erikhafnor/surdeigsbaker/docs/beslutninger/README.md

# Beslutningslogg (ADR)

Viktige valg dokumenteres som korte *Architecture Decision Records* (ADR). En ADR forteller hva som ble valgt, hvorfor og hvilke alternativer som ble forkastet. Da kan nye bidragsytere og «framtidige deg» forstå valgene uten å gjette.

Mal: [`ADR-000-mal.md`](ADR-000-mal.md). Filnavn: `ADR-NNN-kort-tittel.md`.

| ID | Tittel | Status | Port |
|---|---|---|---|
| [ADR-000](ADR-000-mal.md) | Mal | – | – |
| [ADR-001](ADR-001-konseptvalg.md) | Konseptvalg for prototype v1 | Avgjort i ADR-010 | G3 |
| [ADR-002](ADR-002-plattform-maaleoppsett.md) | Plattform for måleoppsettet (fase 1) | Foreslått | G0 |
| [ADR-003](ADR-003-sprak-og-lisens.md) | Dokumentasjonsspråk og lisenser | Foreslått | G0 |
| ADR-004 | Hovedstyring for prototypen | Åpen | G2 |
| [ADR-005](ADR-005-verktoykjede.md) | Verktøykjede for design med AI-agenter | Foreslått | G0 |
| [ADR-006](ADR-006-steking-i-vanlig-ovn.md) | Maskinen leverer stekeklar deig, og stekingen skjer i vanlig ovn | **Vedtatt** | G0 |
| [ADR-007](ADR-007-ingen-kjoling.md) | Ingen kjøling i maskinen – kald etterheving skjer i brukerens kjøleskap | **Vedtatt** | G0 |
| [ADR-008](ADR-008-v0-design.md) | Første maskindesign (v0): benkemaskin med C-krok, varmeplate og 24 V | Erstattet av ADR-010 (v0 bygges ikke) | G2 |
| [ADR-009](ADR-009-kamera.md) | Kamera i maskinen – analysen gjøres utenfor maskinen («tynn kant») | Foreslått | G3 |
| [ADR-010](ADR-010-v1-arkitektur.md) | Prototype v1: brødmaskinform med vekt, dosering av mel, salt og vann, og tidsplanlegger | **Vedtatt** | G3 |
