erikhafnor/surdeigsbaker/docs/forskning/README.md

# Kunnskapsnotater (FO1–FO8)

Ett kort notat (1–3 sider) per forskningsområde i [forskningsplanen](../02-forskningsplan.md). Notatene skal være ferdige ved port G0.

| Fil | Område | Status |
|---|---|---|
| `FO1-prosess-og-mikrobiologi.md` | Prosess og mikrobiologi | ⚪ |
| `FO2-kjente-losninger.md` | Kjente løsninger og patenter | 🟡 forstudie gjort |
| `FO3-sensorer.md` | Sensorer | 🟡 forstudie gjort |
| `FO4-mekanikk.md` | Mekanikk og håndtering | ⚪ |
| `FO5-termikk.md` | Termikk | 🟡 grove tall i arkitekturdokumentet |
| `FO6-styring.md` | Styring og programvare | 🟡 plattformsammenligning gjort |
| `FO7-sikkerhet.md` | Sikkerhet og regelverk | 🟡 se 06-sikkerhet.md |
| `FO8-brukeropplevelse.md` | Brukeropplevelse | ⚪ |

Forstudien er oppsummert i [`02-forskningsplan.md`](../02-forskningsplan.md) under «foreløpige funn».

## Verktøyrapporter (verifisert 2026-10-13)

Hva som er det beste innen åpne verktøy for agentstyrt design. Rapportene er samlet i [`10-verktoykjede.md`](../10-verktoykjede.md).

- [3D/mekanisk CAD](verktoy/3d-cad.md)
- [Simulering, produksjon og visualisering](verktoy/simulering-og-produksjon.md)
- [Elektronikkdesign (EDA)](verktoy/elektronikk-eda.md)
- [Kretssimulering, fastvare og lab](verktoy/firmware-simulering-lab.md)

## Andre undersøkelser

- [Kamera og AI i maskinen](kamera-og-ai.md) (2026-10-16): maskinvare, hva andre har gjort, metoder og praktiske problemer. Grunnlag for [ADR-009](../beslutninger/ADR-009-kamera.md).
