erikhafnor/surdeigsbaker/docs/01-prosessanalyse.md

# 01 – Prosessanalyse: fra håndgrep til maskinfunksjoner

Her brytes referanseoppskriften ([`oppskrifter/referanse-v7.md`](../oppskrifter/referanse-v7.md)) ned i **maskinfunksjoner**. For hver funksjon vurderer vi hvor vanskelig den er å automatisere og hvilke løsninger som finnes. Til slutt foreslår vi en *maskinvennlig prosess*, som er en hypotese som eksperimentene skal teste.

**Avgrensning ([ADR-006](beslutninger/ADR-006-steking-i-vanlig-ovn.md) og [ADR-007](beslutninger/ADR-007-ingen-kjoling.md)):** Maskinen slutter når deigen er **klar for forming** (trinn 1–6). Forming, kald etterheving i eget kjøleskap og steking i vanlig ovn (trinn 7–15) gjøres av mennesket.

## Prosessflyt

Fargene viser hvor vanskelig hvert trinn er å automatisere: grønn er lett, gul middels og rød vanskelig. Grå trinn gjøres av mennesket.

```mermaid
flowchart LR
  subgraph M["Maskinen"]
    A["1 Mate surdeig / levain<br/>ca. 8 t, lunt"]:::hard --> B["2 Dosere mel og vann<br/>26 °C"]:::mid
    B --> C["3 Autolyse<br/>25–60 min"]:::easy
    C --> D["4 Salt og levain"]:::mid
    D --> E["5 Elting<br/>10 min"]:::easy
    E --> F["6 Bulkheving<br/>2–3 t, bretting"]:::mid
  end
  F -->|"varsel: klar for forming"| G
  subgraph U["Du, kjøleskapet og ovnen"]
    G["7–8 Forming<br/>(2–5 min)"]:::human --> H["9–10 Kald etterheving<br/>i kjøleskapet, 8–24 t"]:::human
    H --> I["11 Forvarm ovn og gryte"]:::human --> J["12 Tipp i gryta og snitt"]:::human
    J --> K["13–14 Steking<br/>250 → 200 °C"]:::human --> L["15 Avkjøling"]:::human
  end
  classDef easy fill:#d4edda,stroke:#2e7d32,color:#000
  classDef mid fill:#fff3cd,stroke:#b8860b,color:#000
  classDef hard fill:#f8d7da,stroke:#b71c1c,color:#000
  classDef human fill:#e2e3e5,stroke:#6c757d,color:#000
```

## Funksjonsanalyse

| # | Manuelt steg | Maskinfunksjon | Krav (utkast) | Vanskelighet | Kandidatløsninger | Kan forenkles? |
|---|---|---|---|---|---|---|
| 1 | Mate surdeig | Kassere, dosere mel og vann, røre, holde temperatur, oppdage når surdeigen er klar | ±2 g, 24–28 °C ±0,5 °C | **Høy** (klissent, hygiene, mugg) | Bygge levain direkte i bollen, peristaltisk pumpe for flytende surdeig, ToF-sensor for heving, modell for tid og temperatur | **Ja:** Med levain i bollen tilsetter mennesket bare 1 ss surdeig (N3) |
| 2 | Veie mel og vann | Dosere og veie, temperere vannet | Mel ±1 %, vann ±1 %, vann 26 ±1 °C | Middels | Lastceller under bollen (én vekt for alt), skrue- eller sneglemater for mel, peristaltisk pumpe eller magnetventil for vann | Nei, men på N2 gjør mennesket det |
| 3 | Autolyse | Vente og holde temperatur | 25–60 min | Lav | Temperaturstyrt kammer | Kanskje. Kan bli «fermentolyse» med levain fra start (E04). |
| 4 | Salt og levain | Dosere salt, blande inn levain | Salt ±0,5 g | Middels | **Salt som saltlake** (bassinage-prinsippet), laget av maskinen selv av tørt salt fra en snegle eller cellehjulsdoserer og vann (E12) | **Ja:** Saltlake gjør tørrstoffdosering om til væskedosering |
| 5 | Elting | Motor med krok eller padle | ca. 10 min, lav hastighet, ca. 1 kg deig | Lav | Brødmaskinpadle, spiralkrok, motor fra kjøkkenmaskin | – |
| 6 | Bulkheving med strekk og brett | Holde temperatur, bearbeide deigen med jevne mellomrom, måle heving | 24–27 °C, bretting hver 30. min, +20–25 % volum | Middels | Korte og langsomme krokomdreininger, ToF-sensor eller kamera for heving | **Ja:** Bretting kan kanskje erstattes av mer elting eller korte omrøringer (E05) |
| 7–8 | Forforming og endelig forming | Gi overflatespenning og stram form | – | **Svært høy** for maskin, **2–5 min** for menneske | Ingen forming der gryta er formen, eller at mennesket former når maskinen varsler | **Ja:** Variant «uten forming» (E06), eller manuell forming |
| 9–10 | Etterheving og kald heving | **Utenfor maskinen** ([ADR-007](beslutninger/ADR-007-ingen-kjoling.md)). Mennesket setter kurven (eller bollen) i sitt eget kjøleskap. | Kjøleskap 4–6 °C, 8–24 t | – | Brukerens kjøleskap | **Ja:** Ingen kjøling i maskinen |
| 11 | Forvarme ovn og gryte | **Utenfor maskinen.** Mennesket forvarmer når deigen tas ut av kjøleskapet. | Som referansen | Lav | – | – |
| 12 | Overlevering og snitting | **Mennesket** tipper kald deig fra bolle eller kurv i varm gryte og snitter | Uten å punktere deigen | Lav for menneske | Avtakbar bolle eller hevekurv med slippbelegg. Kald deig er lett å snitte. | Kanskje sømsiden opp (E07) |
| 13–15 | Steking og avkjøling | **Utenfor maskinen**, i vanlig ovn | Som referansen | – | – | – |
| – | Rengjøring | – | Mindre enn 5 min per brød | **Høy** | Avtakbare deler som tåler oppvaskmaskin, slippbelegg | Designes inn fra start |

## Hypotese: en maskinvennlig prosess (v0)

Eksperimentene i fase 1 skal bekrefte eller avkrefte denne hypotesen ([`05-eksperimenter.md`](05-eksperimenter.md)):

> **H0:** Et brød laget med prosessen under og stekt som referansen får ≥ 80 % av poengsummen til referansebrødet.

| Trinn | Referanse (v7.0) | Maskinvennlig v0 | Testes i |
|---|---|---|---|
| Levain | Separat glass, flytetest | I bollen. Mennesket tilsetter 1 ss surdeig. Ferdig etter modell (tid og temperatur), senere med sensor. | E02, E03 |
| Autolyse | Mel og vann først, deretter salt og levain | Fermentolyse: alt unntatt salt, deretter saltlake | E04 |
| Bretting | Hver 30. min for hånd | 3–4 korte og langsomme omrøringer med kroken | E05 |
| Forming | Forforming, benkhvile og endelig forming | **A:** Ingen («tipp og stek»). **B:** Mennesket former når maskinen varsler (standard i v0). | E06 |
| Etterheving | 2 t i kurv, så kjøleskap | **A:** Bollen med lokk i kjøleskapet. **B:** Kurven i kjøleskapet. | E09 |
| Venting etter bulk | – | Deigen venter ved romtemperatur til du former den. Maskinen slår av varmen. | E16 |
| Overlevering | Fra kurv til varm gryte | Mennesket tipper kald deig fra bolle (A) eller kurv (B) i varm gryte | E10 |
| Snitting | Kniv eller barberblad | Mennesket snitter, eller sømsiden opp | E07 |
| Steking | 260 °C forvarming, 250 °C med lokk, 200 °C uten | **Uendret**, i vanlig ovn | (E08) |

Hvis H0 holder med variant A, trenger maskinen verken forming eller avansert håndtering av deig. Variant B er en sikker reserveplan som gir referansekvalitet med to korte manuelle grep.

## Tidsplanlegging bakover («klar for forming kl. 20:00»)

Med styrt temperatur blir tiden for hvert trinn forutsigbar. Maskinen kan da regne baklengs fra tidspunktet du vil forme deigen:

```text
klar for forming 20:00  →  varsel, du former og setter kurven i kjøleskapet
     ↑
[venting ved romtemperatur: bare noen ti-minutter er trygt (E16)]
     ↑
bulkheving (modell: f(temperatur, levain-andel))  ←  temperaturen justeres for å treffe tiden
     ↑
elting / fermentolyse  ←  levain (modell: f(temperatur, forhold))  ←  start
```

Uten kjøling i maskinen ([ADR-007](beslutninger/ADR-007-ingen-kjoling.md)) finnes det ingen kald buffer *før* forming. Usikkerheten i surdeigens aktivitet (± 1–2 t) må derfor tas opp med **temperaturen** under bulkhevingen: Går den for fort, senkes temperaturen (men aldri under romtemperaturen). Går den for sakte, økes den. Etter formingen er det **kjøleskapet ditt** som er bufferen (8–24 t), så du slipper å steke på minuttet.

Tidsplanleggeren kommer når fermenteringsmodellen fra E02 finnes. Fastvaren i v0 starter når du trykker **Start**, og slutter når hevingen har nådd målet.
