erikhafnor/surdeigsbaker/data/bakelogger/README.md

# Bakelogger

Legg én fil per baking her, basert på [`docs/maler/bakelogg.md`](../../docs/maler/bakelogg.md). Den første skal være **E01 – referansebrød nr. 1**.
