erikhafnor/surdeigsbaker/docs/03-konsepter.md

# 03 – Konseptalternativer

> **Oppdatert 2026-10-17:** Maskinen har **ingen kjøling** ([ADR-007](beslutninger/ADR-007-ingen-kjoling.md)). Den slutter når deigen er klar for forming, og du bruker ditt eget kjøleskap til den kalde etterhevingen. **Prototype v1 er valgt i [ADR-010](beslutninger/ADR-010-v1-arkitektur.md):** en blanding av K2 og K1. Fra K2 kommer det isolerte kammeret med svak varme, dosering og vekt. Fra K1 kommer brødmaskinformen med elteblad i bunnen, men drevet av en egen girmotor. Det første designet, v0 (K2 med krok fra lokket), bygges ikke. Teksten under er skrevet før dette. Det som gjelder kjøling, er ikke lenger aktuelt.

Maskinen leverer deig som er **klar for forming**, og stekingen skjer i vanlig ovn ([ADR-006](beslutninger/ADR-006-steking-i-vanlig-ovn.md)). Da er de viktigste valgene i arkitekturen:

- **Hvordan elter og bearbeider maskinen deigen?** Brødmaskinpadle, krok eller kjøkkenmaskin.
- **Hvordan varmes deigen?** Varmeplate under bollen eller varm luft i kammeret. (Ingen kjøling etter ADR-007.)
- **Hvordan får mennesket deigen ut?** Avtakbar bolle eller hevekurv.

Under er fire konsepter. Valget skulle tas ved port G3 med Pugh-matrisen nederst. Det ble i stedet tatt i [ADR-010](beslutninger/ADR-010-v1-arkitektur.md) ut fra undersøkelsene for v1 (se [ADR-001](beslutninger/ADR-001-konseptvalg.md)).

## K1 – Brødmaskin i kjøleskap

Drivverket og formen fra en brukt brødmaskin bygges inn i et **ombygd lite vinkjøleskap eller en kjøleboks med kompressor**. Den får ny styring, et svakt varmeelement og egne sensorer.

```text
┌───────────────────────────────┐
│ isolert kammer (vinkjøleskap) │ ← kompressor 4–6 °C, varmefolie til 24–30 °C
│   ┌──────────────┐            │
│   │ brødform     │  ToF ↓     │ ← avtakbar form med slippbelegg
│   │   padle      │            │
│   └──────┬───────┘            │
│      eltemotor (fra brødmaskin) │
│ ESP32 · SSR/relé · termosikring │
└───────────────────────────────┘
```

- **+**
  - Billig: brødmaskin og vinkjøleskap kan kjøpes brukt på Finn.no.
  - Kort vei til *første maskinlagde surdeigsdeig*.
  - Brødformen er laget for elting og er lett å vaske.
  - Høy DIY-verdi: mange kan bygge den.
- **−**
  - Brødmaskinpadlen behandler deigen grovere enn en krok.
  - Formen er høy og smal, noe som er dårlig for å se og måle bulkhevingen.
  - Motorvarmen havner i kjølekammeret.
  - Lite plass til en hevekurv, og vanskelig å dosere ovenfra (N3).
- **Rolle i planen:** Gangbart skjelett i fase 2. Kan bli en egen, enkel DIY-variant («Surdeigsbaker Mini»).

## K2 – Eltebolle i hevekammer ⭐ grunnlaget for v1 (uten kjøling, med brødmaskinform fra K1)

Et isolert kammer med svak varme (kompressorkjøling i den opprinnelige versjonen, fjernet i ADR-007). I kammeret står en **avtakbar bolle i rustfritt stål** på lastceller, og en **eltekrok som drives ovenfra** av en girmotor i lokket. Lokket har også ToF-sensor og innløp for dosering. Kammeret har plass til en hevekurv ved siden av eller i stedet for bollen.

```text
┌───────────────────────────────────┐
│  Melbeholder      Vann · salt     │ ← påfylles ukentlig (N3)
├────────── lokk ───────────────────┤
│  girmotor → krok   ToF   innløp   │
├───────────────────────────────────┤
│   avtakbar bolle (rustfritt)      │ ← 4–30 °C
│   på lastceller   │ plass til     │
│                   │ hevekurv      │
│ kompressor · varme · ESP32/MCU    │
└───────────────────────────────────┘
```

- **+**
  - Kroken gir god deigbehandling og fungerer godt til korte bretterunder (E05).
  - Bulkhevingen er lett å måle ovenfra.
  - Dosering ovenfra gjør N3 mulig.
  - Bollen og kroken tåler oppvaskmaskin.
  - Støtter begge overleveringsvariantene («tipp og stek» og «med forming»).
- **−**
  - Mer mekanisk arbeid: lokk med motor og en kobling som må kunne løftes av.
  - Motorvarme og kondens i kammeret må håndteres.
- **Kritiske eksperimenter:** E05 (bretting med krok), E06 (uten forming), E10 (overlevering), E13 (varme) og **E17 (eltetest)**.

## K3 – Kjøkkenmaskin og smart hevekabinett

Den kjøkkenmaskinen du har, brukes til elting. Det som bygges, er bare et **smart hevekabinett** med varme, hevemåling, tidsplan og varsling. Mennesket flytter bollen mellom kjøkkenmaskinen og kabinettet og gjør bretting og forming.

- **+**
  - Lavest teknisk risiko.
  - Raskest i bruk: dette er hevekassen fra fase 1.
  - Gir referansekvalitet, fordi mennesket gjør alle håndgrepene.
  - Nyttig i hverdagen allerede på N1.
- **−**
  - Lav automasjon: mennesket må gjøre flere grep og være til stede oftere.
  - To apparater på benken.
- **Rolle i planen:** Første nyttige milepæl (N1), og plattformen for alle eksperimentene i fase 1.

## K4 – Heving i stekegryta (kaldstart)

Den siste hevingen skjer i din egen jerngryte, med bakepapir, inne i maskinens kammer. Ved stekeklar tid setter du hele gryta i en **kald** ovn og steker med kaldstart.

- **+** Ingen tipping av deig. Bakepapiret fungerer som slynge.
- **−**
  - Kaldstart kan gi mindre ovnsspretthet (E08).
  - Kammeret må romme en tung støpejernsgryte, og det er mye masse å kjøle ned.
  - Kald emaljert gryte inn i varm ovn må unngås, fordi emaljen kan sprekke av temperatursjokk.
- **Rolle:** Utgår etter ADR-007, fordi maskinen ikke lenger har kaldt kammer. Kaldstart i gryte kan fortsatt testes i E08 med brukerens kjøleskap.

## Foreløpig Pugh-matrise

Konsept K2 er referanse (0). De andre konseptene vurderes mot K2 fra −2 (mye dårligere) til +2 (mye bedre). Vektene skal kalibreres i fase 0. Poengene oppdateres etter eksperimentene i fase 1 og 3.

| Kriterium | Vekt | K1 | K2 | K3 | K4 |
|---|---|---|---|---|---|
| Deigkvalitet | 5 | −1 | 0 | +1 | −1 |
| Teknisk risiko (lav er bra) | 4 | +1 | 0 | +2 | 0 |
| Automasjonsnivå mulig i v1 | 4 | −1 | 0 | −2 | 0 |
| Kostnad | 3 | +2 | 0 | +1 | 0 |
| Fotavtrykk på benken | 3 | 0 | 0 | −1 | −1 |
| Rengjøring | 3 | 0 | 0 | 0 | 0 |
| Byggbarhet som DIY | 3 | +1 | 0 | +2 | 0 |
| Tid til første brød | 2 | +2 | 0 | +2 | 0 |
| **Vektet sum** | | **+8** | **0** | **+15** | **−8** |

Matrisen må leses riktig. K3 skårer høyest fordi den er enkel, men den når bare N1. K1 er billig og rask, men egner seg dårlig for dosering (N3). **K2 er den reelle kandidaten for prototype v1 (N3).** K1 og K3 er trinn på veien dit, og de er nyttige ferdige maskiner i seg selv.

## Anbefaling: en trapp der hvert trinn er nyttig

Den opprinnelige trappen var:

1. **Fase 1, K3 (N1):** Hevekabinett med varme, sensorer og tidsplan som eksperimentkammer.
2. **Fase 2, K1 (N2):** Drivverket og formen fra en brødmaskin i kabinettet.
3. **Fase 3–4, K2 (N3):** Den egentlige eltemodulen med bolle, krok, vekt og dosering.

**Etter ADR-007, ADR-008 og ADR-010** bygges K2 uten kjøling direkte som **prototype v1 (N3)**, med formen og eltebladet fra K1. Trinn 1 og 2 blir valgfrie, og v0 bygges ikke. Eksperimentene i fase 1 kan gjøres for hånd eller i v1.
