erikhafnor/surdeigsbaker/docs/08-kilder.md

# 08 – Kilder og leseliste

Kildelisten ble satt sammen i forstudien i oktober 2026. **De fleste nettsidene er funnet via søkeresultater og er ikke lest i sin helhet.** Kilder på GitHub er lest direkte. Viktige tall bør sjekkes i originalkilden før vi bygger på dem. Legg gjerne til nye kilder med en kort merknad om hva den er nyttig til.

⭐ = start her

## Bøker

- ⭐ Chad Robertson: *Tartine Bread*. Grunnlaget for referanseoppskriften.
- ⭐ Trevor J. Wilson: *Open Crumb Mastery* (2. utg.). Om fermentering og struktur, uten oppskrifter. <https://trevorjaywilson.sellfy.store/p/open-crumb-mastery/>
- Jeffrey Hamelman: *Bread*, 3. utg. (Wiley 2021), ISBN 9781119577515
- Maurizio Leo: *The Perfect Loaf* (Clarkson Potter 2022), ISBN 9780593138410
- Ken Forkish: *Flour Water Salt Yeast*, ISBN 9781607742739. Inneholder bl.a. teknikken med sømsiden opp.
- Nathan Myhrvold og Francisco Migoya: *Modernist Bread* (2017)
- Gobbetti og Gänzle (red.): *Handbook on Sourdough Biotechnology*, 2. utg. (2023)
- ⭐ *The Sourdough Framework*, en åpen bok om surdeig: <https://github.com/hendricius/the-sourdough-framework>

## Fagartikler og vitenskap

- Gänzle, Ehmann og Hammes (1998): modell for hvordan pH, temperatur og salt påvirker surdeigsorganismene. *Appl. Environ. Microbiol.* 64:2616. <https://pmc.ncbi.nlm.nih.gov/articles/PMC106434>
- Gänzle (2014): «Enzymatic and bacterial conversions during sourdough fermentation». *Food Microbiology* 37:2–10. <https://era.library.ualberta.ca/items/20231cb2-c13f-43c4-9d59-1d686b67f5b8>
- De Vuyst mfl. (2014): «Microbial ecology of sourdough fermentations: diverse or uniform?» <https://research.dial.uclouvain.be/handle/2078.5/39545>
- ⭐ Landis mfl. (2021): Global Sourdough Project, 500 surdeiger. *eLife* 10:e61644. <https://elifesciences.org/articles/61644> (data: <https://datadryad.org/dataset/doi:10.5061/dryad.0p2ngf1z1>)
- Reese mfl. (2020): Om ingredienser og bakernes betydning. *mSphere*. <https://www.ncbi.nlm.nih.gov/pmc/articles/PMC6968659/>
- Romano mfl. (2007): Deigvolum målt med bildeanalyse og Gompertz-modell. *J. Food Eng.* 83(2). <https://iris.unina.it/handle/11588/112136>. Se også *Foods* 12:1809 (2023): <https://www.mdpi.com/2304-8158/12/9/1809>
- Ito mfl. (1992): Dielektrisk måling av gassandel i deig. *Cereal Chem.* 69:325. <https://www.cerealsgrains.org/publications/cc/backissues/1992/Documents/69_325.pdf>
- De Bondt mfl.: «Wheat sourdough breadmaking: a scoping review». <https://research.ucc.ie/en/publications/wheat-sourdough-breadmaking-a-scoping-review/>
- pH og titrerbar syre (TTA): Metrohm. <https://www.metrohm.com/en/discover/blog/20-21/chemical-analysis-of-sourdough--ph-and-total-titratable-acidity-.html>
- Referanseinstrument: KPM Rheo F4 (tidligere Chopin Rheofermentometer). <https://kpmanalytics.com/products/rheo-f4>

## Praktisk bakekunnskap (blogger og forum)

- King Arthur om myter, bl.a. flytetesten: <https://cmsprod.kingarthurbaking.com/blog/2024/04/24/sourdough-myths>
- King Arthur om kald gryte: <https://www.kingarthurbaking.com/blog/2017/07/05/baking-in-a-cold-dutch-oven>
- King Arthur om hvordan man ser at brødet er ferdig: <https://www.kingarthurbaking.com/blog/2023/05/31/how-to-tell-if-bread-is-done>
- Prosent heving i bulk, avhengig av temperatur: <https://thesourdoughjourney.com/the-mystery-of-percentage-rise-in-bulk-fermentation/>
- Ønsket deigtemperatur (DDT): <https://www.bakerybits.co.uk/bakers-blog/desired-dough-temperature-a-baker-s-guide>
- Tid og temperatur, «dobling per ca. 8 °C»: <https://thermoworks.com/blogs/thermoblog/sourdough-times-and-temps>
- Blandingsforhold og tid til topp (anekdotisk): <https://thatsourdoughgal.com/the-ultimate-guide-to-sourdough-starter-feeding-ratios/>
- America's Test Kitchen, no-knead 2.0 (hydrering): <https://www.americastestkitchen.com/articles/41-no-knead-bread-2-dot-0>
- The Fresh Loaf (forum), en gullgruve av erfaringer: <https://www.thefreshloaf.com/>

## Kjente løsninger (produkter)

- ⭐ Sourdough Sidekick (FirstBuild/GE og King Arthur), en automatisk surdeigsmater: <https://www.kingarthurbaking.com/blog/2026/06/23/automatic-sourdough-feeder>
- Brød & Taylor Sourdough Home og Folding Proofer: <https://nz.brodandtaylor.com/pages/faq>, <https://brodandtaylor.com/support>
- Breadwinner, en sensor for surdeigsglass (åpen design fra OSHWA 2021): <https://www.backerkit.com/c/projects/fred-benenson/breadwinner>, <https://2021.oshwa.org/files/2021/04/Breadwinner.pdf>
- Panasonic SD-YR2550, med surdeigsprogrammer og romtemperatursensor: <https://www.panasonic.com/uk/consumer/home-appliances/breadmakers/sd-yr2550.html>
- Zojirushi Virtuoso Plus, med egne «Homemade»-program: <https://www.zojirushi.com/app/product/bbpdc>
- Breville Custom Loaf, med padle som felles ned: <https://www.breville.com/en-us/product/BBM800>
- Målte temperaturer i brødmaskiner (forum): <https://www.thefreshloaf.com/node/72212>
- ⭐ Anova Precision Oven og utvikler-API (trinnliste med betingelser): <https://developer.anovaculinary.com/docs/devices/wifi/oven-commands>
- Suvie, med «Cool-to-Cook»: <https://sousvideguy.com/meet-suvie-one-sous-vide-oven/>
- Whirlpool Polara, et kjøleskap og en ovn i ett (2002): <https://newatlas.com/oven-that-thinks-its-a-refrigerator/1524/>
- Rotimatic, lærdom om dosering: <https://support.rotimatic.com/articles/2057615-imperfect-dough>
- Wilkinson BreadBot: <https://thespoon.tech/four-years-after-ces-breadbots-robotic-breadmaker-is-dishing-out-loaves-at-grocery-stores/>
- Thermomix TM6, gjæringsmodus: <https://cookidoo.be/foundation/en/articles/tm6-modes>

## DIY og åpen kildekode

- ⭐ Justin Lam, surdeigsmonitorer (kamera og ToF med MQTT): <https://github.com/justinmklam/sourdough-starter-monitor>, <https://github.com/justinmklam/iot-sourdough-starter-monitor>
- Surdeigsglass med ToF og CO₂ (SCD30): <https://github.com/AKAMEDIASYSTEM/aka-multispec-jar>
- DIY hevekasse med Raspberry Pi og kamera: <https://github.com/hendricius/diy-proofing-box>
- ⭐ BrewPiLess og Fermentrack, styring av gjæringskammer med varme og kjøling: <https://github.com/vitotai/BrewPiLess>, <https://github.com/thorrak/fermentrack>
- Brødmaskin styrt med Arduino (University of Western Macedonia, 2015): <https://arch.ece.uowm.gr/projects/breadmaker2015/>
- Fastvare for brødmaskin (GPL-3): <https://github.com/bread-maker/bread-maker-firmware>
- Hevekasse med Peltier (The Fresh Loaf): <https://www.thefreshloaf.com/node/31641>
- OnionBot, kjøkkenassistent med maskinsyn: <https://github.com/onionbot/OnionBot-SousChef>

## Industri

- Konisk «rounder»: <https://www.bakeit.it/en/products/conical-bread-dough-rounder>
- Retarder-proofer (kjøl og heving i samme kammer): <https://empirebake.com/lrpr-1-single-door-proofer-retarder>, patent US4674402: <https://patents.google.com/patent/US4674402>
- Deling og runding: <https://innograin.uva.es/en/2023/11/10/division-and-rounding/>
- Snitteroboter (ultralyd og vannstråle): <https://www.koenig-rex.com/en/machines/scoring-unit/>

## Maskinvare og programvare

> Verktøy for CAD, EDA, simulering og fastvare med agentstøtte (MCP) er samlet i [`10-verktoykjede.md`](10-verktoykjede.md) og de fire rapportene i [`forskning/verktoy/`](forskning/verktoy/).

- ⭐ ESPHome (PID-regulering, HX711, NAU7802, MAX318xx): <https://esphome.io/>
- ⭐ Klipper, konfigurasjonsreferanse (varmesikkerhet, `load_cell`, `manual_stepper`): <https://github.com/Klipper3d/klipper/blob/master/docs/Config_Reference.md>
- MadMachine SwiftIO Micro: <https://docs.madmachine.io/hardware/swiftio-micro>, SDK: <https://github.com/madmachineio/mm-sdk>, drivere: <https://github.com/madmachineio/MadDrivers>
- Embedded Swift (ESP32-C6, RP2040 og flere): <https://swift.org/blog/embedded-swift-examples/>
- Datablad for HX711: <https://github.com/sparkfun/HX711-Load-Cell-Amplifier/blob/master/datasheets/hx711F_EN.pdf>
- Datablad for NAU7802: <https://cdn.sparkfun.com/assets/e/c/8/7/6/NAU7802_Data_Sheet_V1.7.pdf>
- Datablad for MAX31865: <https://www.makerguides.com/wp-content/uploads/2024/06/max31865-datasheet.pdf>
- Datablad for STC31 (CO₂ 0–100 vol%): <https://cdn.sparkfun.com/assets/4/2/5/0/6/STC31_datasheet.pdf>
- ST AN5231, dekkvindu for VL53L1X: <https://cdn.sparkfun.com/assets/learn_tutorials/7/8/4/an5231-cover-window-guidelines-for-the-vl53l1x-longdistance-ranging-timeofflight-sensor-stmicroelectronics.pdf>
- Secop BD35F, 12/24 V kompressor: <https://www.secop.com/fileadmin/user_upload/SEPS/datasheets/en/bd35f2_101z0700_r134a_12-24vdc_02-2026_desd102n202.pdf>
- Peltier-kammer, målt COP: <https://iifiir.org/en/fridoc/optimization-of-operational-conditions-for-a-thermoelectric-141528>
- Brodannelse og «ratholing» i pulverdosering: <https://www.processingmagazine.com/material-handling-dry-wet/weighers-feeders/article/53079307/understanding-ratholing-and-bridging-phenomena-in-bulk-powder-feeding>

## Sikkerhet og regelverk

- ⭐ DSB, elsikkerhet og elektriske produkter: <https://www.dsb.no/elsikkerhet/elektriske-produkter/elektriske-produkter/>
- DSB, hva du kan gjøre selv: <https://www.dsb.no/en/Safe-everyday-life/Eletricity/Electrical-work_91-You-can-do-this-yourself/>
- DSB, produsentens plikter: <https://www.dsb.no/produkter-og-forbrukertjenester/veiledning/produsentens-forpliktelser/>
- DSB, evaluering av komfyrvaktkampanjen (statistikk over komfyrbranner): <https://www.dsb.no/contentassets/8af8e1908ed04de18d925b8c6836f46d/evalueringsrapport_komfyrvaktkampanjen_2017.pdf>
- Regjeringen, elektrisk utstyr (FEU) og EMC: <https://www.regjeringen.no/en/topics/business-and-industry/product-contact-point/general-rules/electrical-equipment/id2830912/>
- Mattilsynet, matkontaktmaterialer: <https://mattilsynet.no/mat-og-drikke/matproduksjon/matkontaktmaterialer/produksjon-import-og-salg-av-matkontaktmaterialer>
- EU-forordning 1935/2004 (rammeforordningen for matkontakt): <https://www.ruokavirasto.fi/en/foodstuffs/food-sector/packages-and-other-food-contact-materials/rules-for-food-contact-materials/framework-regulation-eu-19352004/>
- Maskinforordningen (EU) 2023/1230: <https://eur-lex.europa.eu/eli/reg/2023/1230>
- Radioutstyrsdirektivet (RED, 2014/53/EU): <https://eur-lex.europa.eu/eli/dir/2014/53/2022-12-27/eng/pdf>
- IEC 60335-2-9 (omfatter brødmaskiner): <https://www.sis.se/en/produkter/environment-health-protection-safety/domestic-safety/iec-60335-2-92019/>
- PTFE og polymerrøyk (Chemours): <https://www.teflon.com/en/polymer-fumes>
- BfR om aluminium og sur mat: <https://www.bfr.bund.de/en/press-release/bfr-research-proof-of-the-transfer-of-aluminium-from-menu-trays-to-food/>
- Trådtrekk (rope) i brød, *Bacillus*: <https://pmc.ncbi.nlm.nih.gov/articles/PMC9564316>
- Mattrygghet ved 3D-print: <https://wiki.comakingspace.de/3D_printing_food_safety>

## Mulige fagmiljøer og nettverk

- **Nofima**, norsk matforskningsinstitutt med korn- og bakeforskning. Kan være aktuelt for en faglig samtale eller instrumenttilgang.
- **Lokale håndverksbakerier**, for kunnskap om praksis og deigforståelse
- **Universitetets verksteder og makerspace** (f.eks. ved UiS), for verktøy og fagfolk
- **Nettsamfunn:** The Fresh Loaf, r/Sourdough, r/Breadit og norske surdeigsgrupper på Facebook. Hackaday.io egner seg som byggelogg.
