erikhafnor/surdeigsbaker/docs/beslutninger/ADR-001-konseptvalg.md

# ADR-001: Konseptvalg for prototype v1

- **Status:** avgjort i [ADR-010](ADR-010-v1-arkitektur.md) (brødmaskinform med elteblad i bunnen, vekt og dosering).
- **Dato:** –
- **Port:** G3

## Kontekst

Se [`03-konsepter.md`](../03-konsepter.md). Maskinen leverer deig som er klar for forming. Stekingen skjer i vanlig ovn ([ADR-006](ADR-006-steking-i-vanlig-ovn.md)), og den kalde etterhevingen i brukerens kjøleskap ([ADR-007](ADR-007-ingen-kjoling.md)).

**Oppdatert 2026-10-16:** v0 er designet som K2 uten kjøling ([ADR-008](ADR-008-v0-design.md)). Denne ADR-en gjelder nå valget for **v1**, og tas med data fra v0. **K3 (smart hevekabinett)** og **K1 (brødmaskin)** er ikke lenger nødvendige trinn på veien.

## Data som trengs før beslutningen

| Eksperiment | Spørsmål | Resultat |
|---|---|---|
| E05 | Kan bretting gjøres av maskinen? | – |
| E06 | Trengs forming? | – |
| E07 | Trengs snitting? | – |
| E09 | Kald bulkheving eller kald etterheving? | – |
| E10 | Er overleveringen enkel for mennesket (bolle eller kurv)? | – |
| E13 | Holder varmeplaten deigen på 24–27 °C ±0,5 °C? | – |
| E16 | Hvor lenge kan deigen vente ved romtemperatur etter bulk? | – |
| E17 | Elter C-kroken i v0 godt nok? | – |

## Beslutning

–

## Konsekvenser

–
