erikhafnor/surdeigsbaker/docs/maler/bakelogg.md

# Bakelogg – mal

> Kopier filen til `data/bakelogger/ÅÅÅÅ-MM-DD-kortnavn.md`, eller opprett et issue med malen «Bakelogg». Fyll inn det du kan. Tomme felt er bedre enn gjetning.

## Grunndata

| Felt | Verdi |
|---|---|
| Dato | |
| Bakt av | menneske / maskin (versjon: …) |
| Oppskrift og versjon | f.eks. `referanse-v7` eller `maskinvennlig-v0` |
| Eksperiment-ID | f.eks. E05-b (eller «–») |
| Automasjonsnivå | N0–N5 |
| Overlevering | A «tipp og stek» / B «med forming» |
| Klar for forming: planlagt / faktisk | kl. … / kl. … (avvik: … min) |
| Ventetid før forming / tid i kjøleskap | … min / … t |

## Ingredienser (veid)

| Ingrediens | Merke / parti | Gram | Temperatur (°C) |
|---|---|---|---|
| Siktet hvetemel | | | |
| Sammalt mel | | | |
| Vann | | | |
| Salt | | | – |
| Levain | | | |

Romtemperatur: … °C. Relativ luftfuktighet: … %.

## Levain

| Matet kl. | Forhold (kultur:mel:vann) | Temperatur | Topp kl. | Hevefaktor ved topp | Flytetest (kl. / resultat) | pH (valgfritt) |
|---|---|---|---|---|---|---|
| | | | | | | |

## Prosess

| Trinn | Start | Slutt | Deigtemperatur (°C) | Merknad (bretting, konsistens …) |
|---|---|---|---|---|
| Blanding | | | | |
| Autolyse | | | | |
| Elting | | | | |
| Bulkheving | | | | Heving i måleglass: … % |
| Forforming og benkhvile | | | | |
| Endelig forming | | | | |
| Etterheving på benk | | | | |
| Kald heving | | | | Kjøleskap: … °C |
| Forvarming | | | | Gryte: … |
| Steking med lokk | | | | … °C |
| Steking uten lokk | | | | … °C |

## Resultat

| Måling | Verdi |
|---|---|
| Deigvekt før steking (g) | |
| Brødvekt etter avkjøling (g) | |
| Stekesvinn (%) | |
| Kjernetemperatur ved uttak (°C) | |
| Volum (ml), med metode | |
| Spesifikt volum (ml/g) | |
| Høyde / bredde (cm) | |

## Brødkort (1–5)

Se [brødkortet](../00-visjon-og-suksesskriterier.md#brødkortet-kvalitetsmåling).

| Volum (25 %) | Form (15 %) | Krumme (20 %) | Skorpe (15 %) | Smak (20 %) | Gjennomstekt (5 %) | **Vektet sum** |
|---|---|---|---|---|---|---|
| | | | | | | |

## Bilder

- [ ] Hele brødet ovenfra og fra siden, med linjal i bildet
- [ ] Snitt gjennom midten, med linjal i bildet
- [ ] Skorpe i nærbilde

## Notater og lærdom

-
