erikhafnor/surdeigsbaker/docs/beslutninger/ADR-000-mal.md

# ADR-NNN: Tittel

- **Status:** foreslått / vedtatt / erstattet av ADR-XXX / forkastet
- **Dato:**
- **Port:** G0–G5

## Kontekst

Hvilket problem skal løses? Hvilke krav, begrensninger og data (eksperimenter) er relevante?

## Alternativer

1. **Alternativ A:** fordeler og ulemper
2. **Alternativ B:** fordeler og ulemper

## Beslutning

Vi velger … fordi …

## Konsekvenser

Hva blir enklere, hva blir vanskeligere, og hva må følges opp?
