erikhafnor/surdeigsbaker/docs/maler/eksperiment.md

# Eksperiment EXX – navn

| Felt | Verdi |
|---|---|
| ID | EXX (se [eksperimentplanen](../05-eksperimenter.md)) |
| Status | planlagt / pågår / ferdig / avbrutt |
| Ansvarlig | |
| Dato (start–slutt) | |
| Forskningsområde | FO1–FO8 |
| Prioritet | 🔴 / 🟠 / 🟢 |

## Spørsmål

Hva skal vi finne ut? Hvilken designbeslutning avhenger av svaret?

## Hypotese

«Vi tror at …, og regner hypotesen som bekreftet hvis …»

## Metode

- **Varianter:** (a) referanse, (b) …, (c) …
- **Faste faktorer:** oppskrift, melparti, temperaturer …
- **Antall repetisjoner:** ≥ 2
- **Utstyr:**

## Målinger

| Måling | Metode / sensor | Enhet | Oppløsning |
|---|---|---|---|
| | | | |

## Kriterium for bestått

## Resultater

Lenke til rådata i `data/` og bakelogger. Grafer.

## Konklusjon og konsekvens for designet

- Hva lærte vi?
- Hvilke beslutninger (ADR) eller dokumenter må oppdateres?
- Nye spørsmål?
