erikhafnor/surdeigsbaker/hardware/v1/bilder/v1_lukket.png

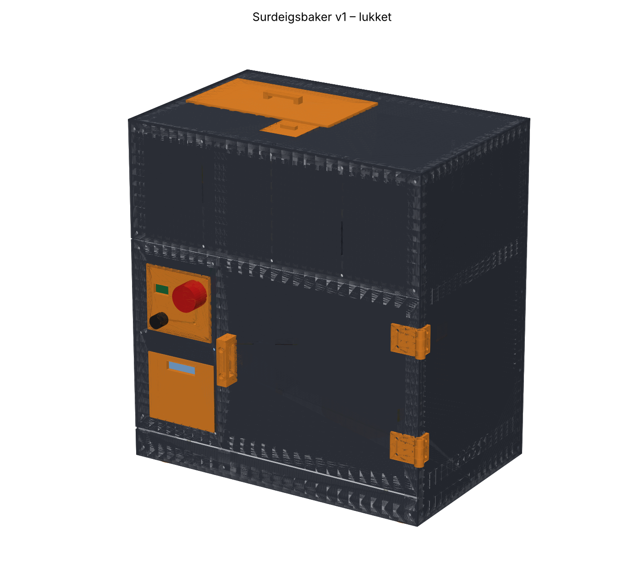
hardware/v1/bilder/v1_lukket.png
