erikhafnor/surdeigsbaker/hardware/v1/bilder/v1_snitt_front.png

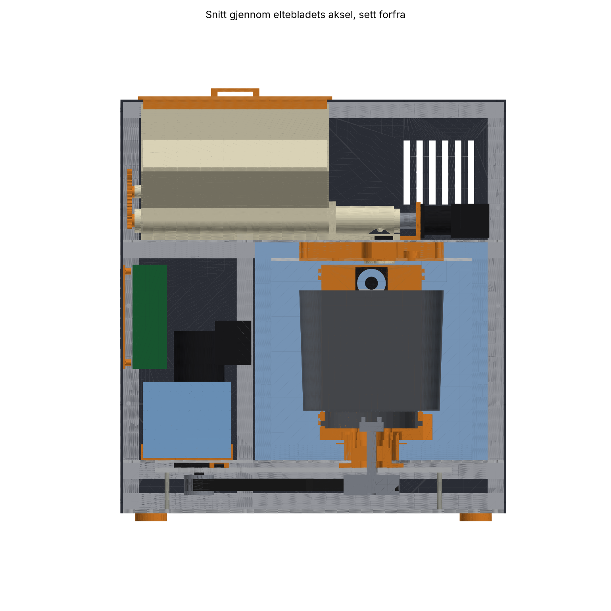
hardware/v1/bilder/v1_snitt_front.png
