erikhafnor/surdeigsbaker/hardware/v1/tegninger/plater_oversikt.png

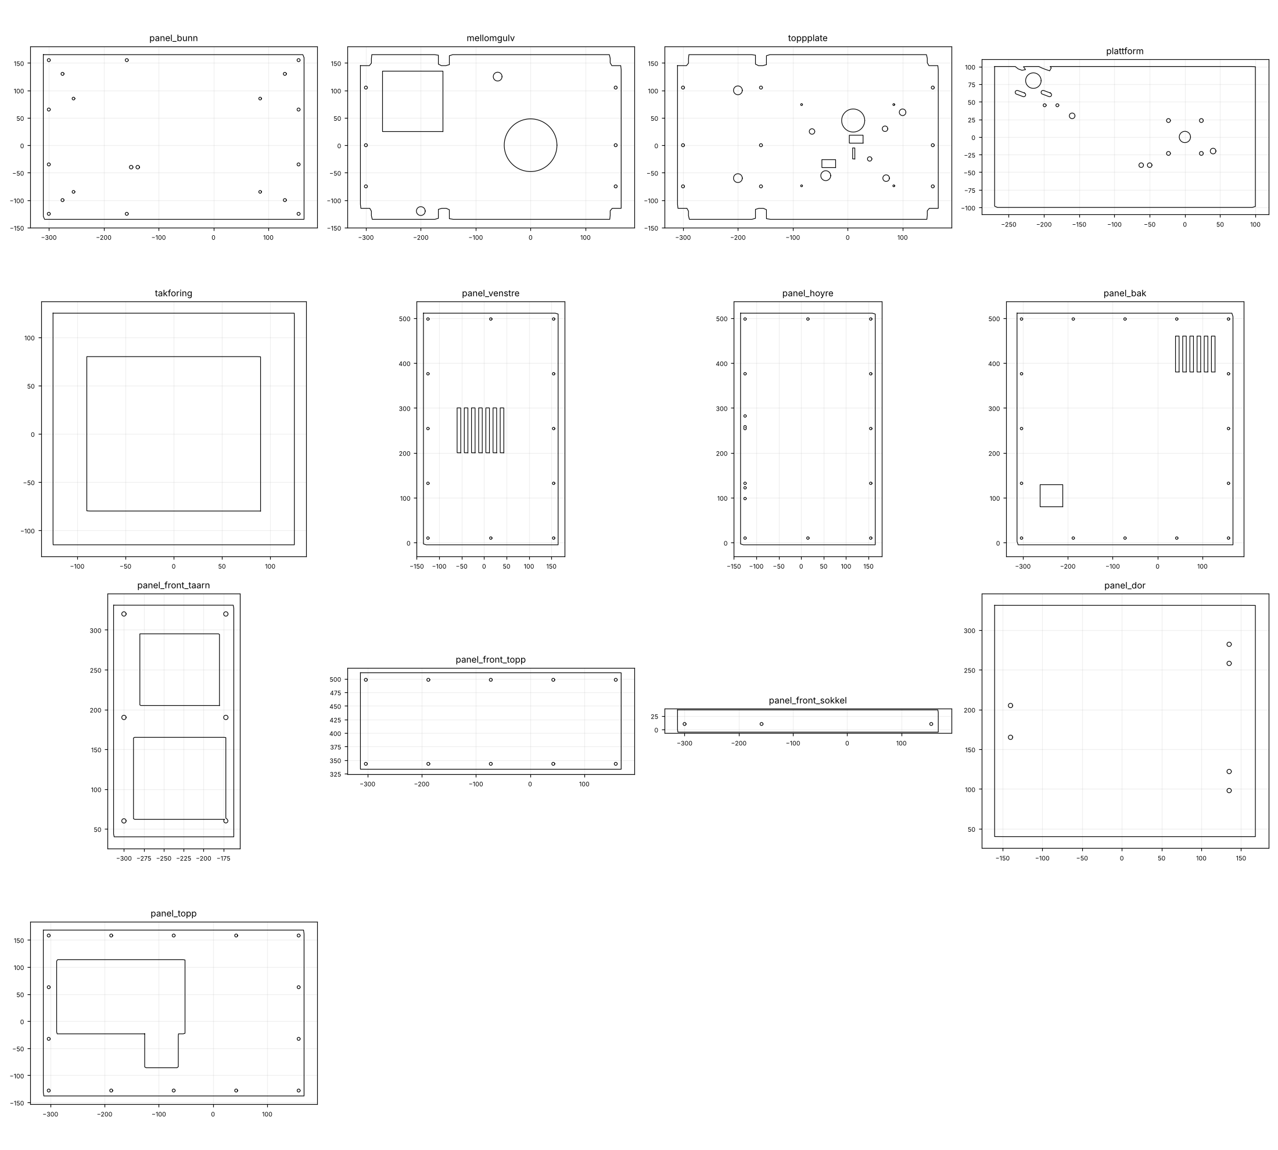
hardware/v1/tegninger/plater_oversikt.png
