erikhafnor/surdeigsbaker/hardware/v1/dxf/panel_dor.dxf

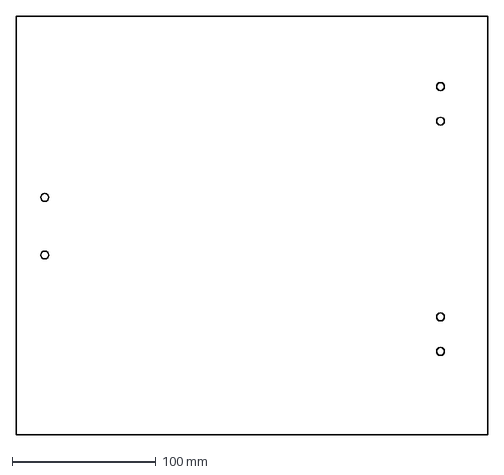
[picture p9: CAD file, 2026-10-16]
hardware/v1/dxf/panel_dor.dxf
328.0 x 291.0 mm
