erikhafnor/surdeigsbaker/hardware/v1/step/dorhandtak.step

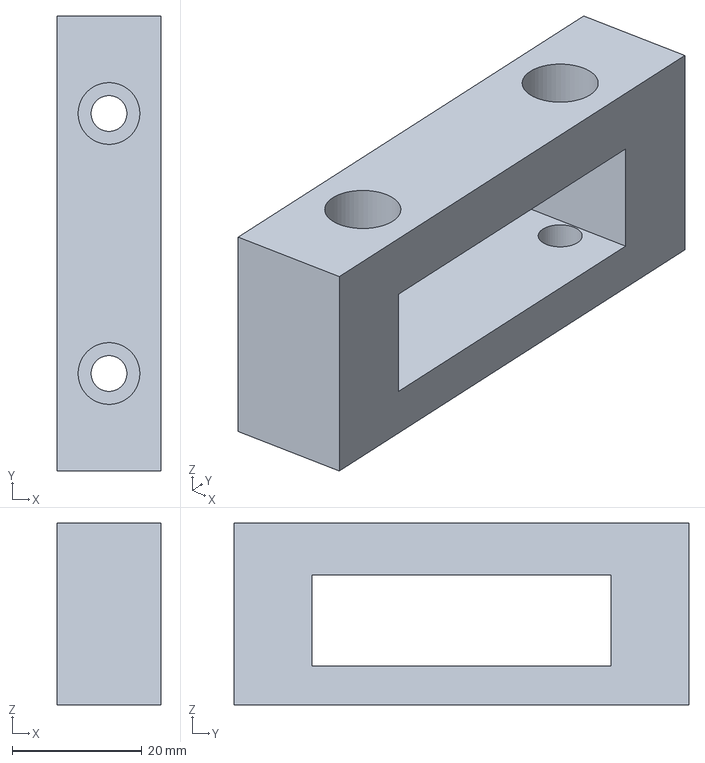
[picture p10: CAD file, 2026-10-16]
hardware/v1/step/dorhandtak.step
16.0 x 70.0 x 28.0 mm
