erikhafnor/surdeigsbaker/hardware/v1/dxf/panel_venstre.dxf

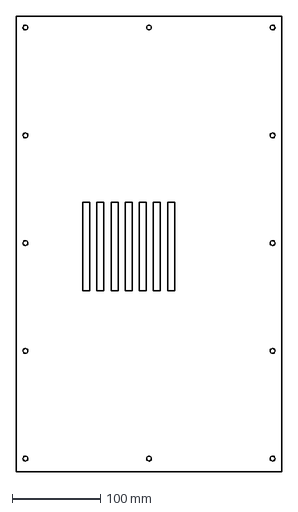
[picture p11: CAD file, 2026-10-16]
hardware/v1/dxf/panel_venstre.dxf
300.0 x 516.0 mm
