erikhafnor/surdeigsbaker/hardware/v1/step/tankskuff.step

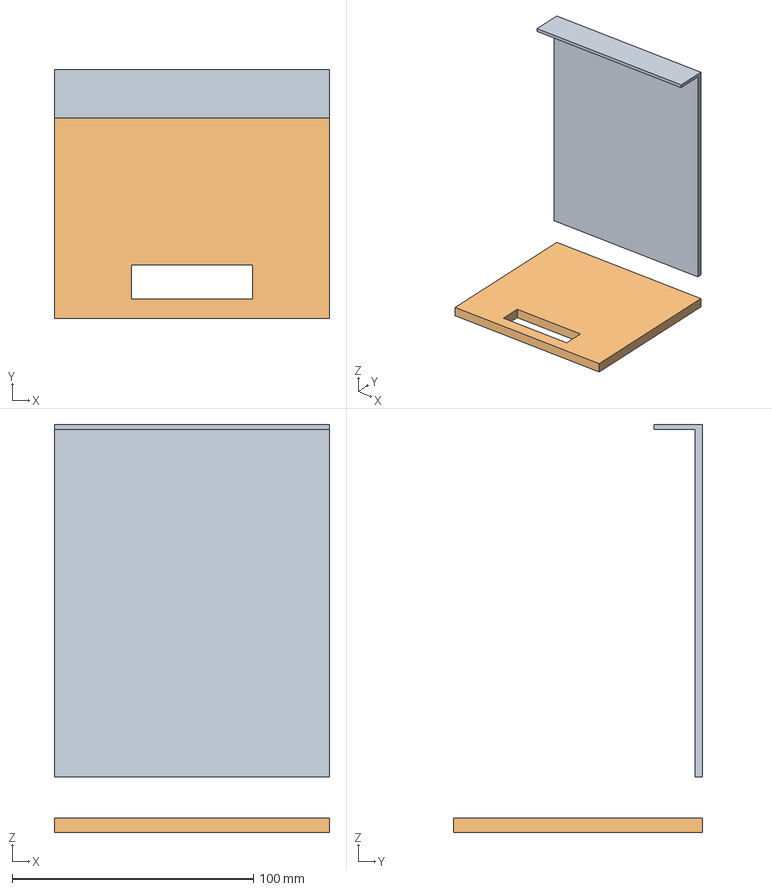
[picture p12: CAD file, 2026-10-16]
hardware/v1/step/tankskuff.step
114.0 x 103.0 x 169.0 mm
