erikhafnor/surdeigsbaker/hardware/v1/dxf/mellomgulv.dxf

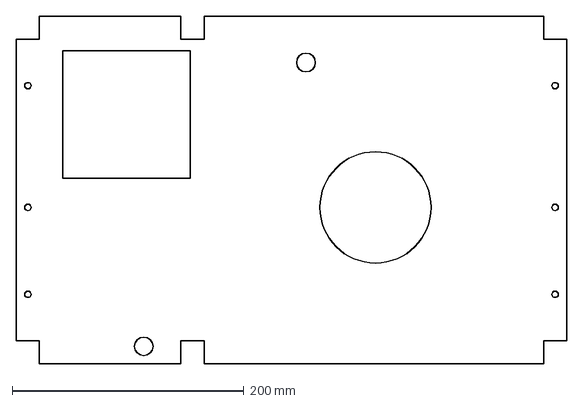
[picture p13: CAD file, 2026-10-16]
hardware/v1/dxf/mellomgulv.dxf
475.0 x 300.0 mm
