erikhafnor/surdeigsbaker/hardware/v1/step/tannhjul_skrue.step

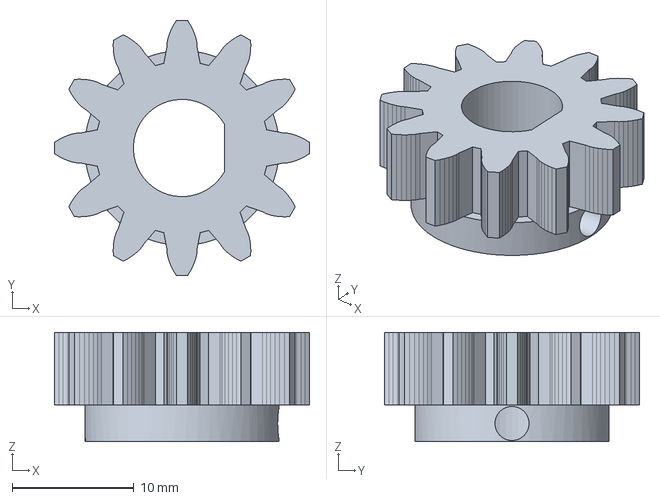
[picture p14: CAD file, 2026-10-16]
hardware/v1/step/tannhjul_skrue.step
21.0 x 21.0 x 9.00 mm
