erikhafnor/surdeigsbaker/hardware/v1/dxf/panel_front_topp.dxf

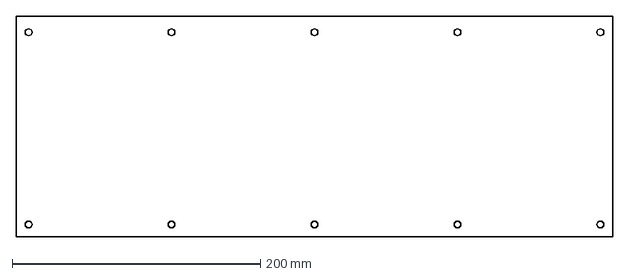
[picture p15: CAD file, 2026-10-16]
hardware/v1/dxf/panel_front_topp.dxf
481.0 x 178.0 mm
