erikhafnor/surdeigsbaker/hardware/v1/step/fot.step

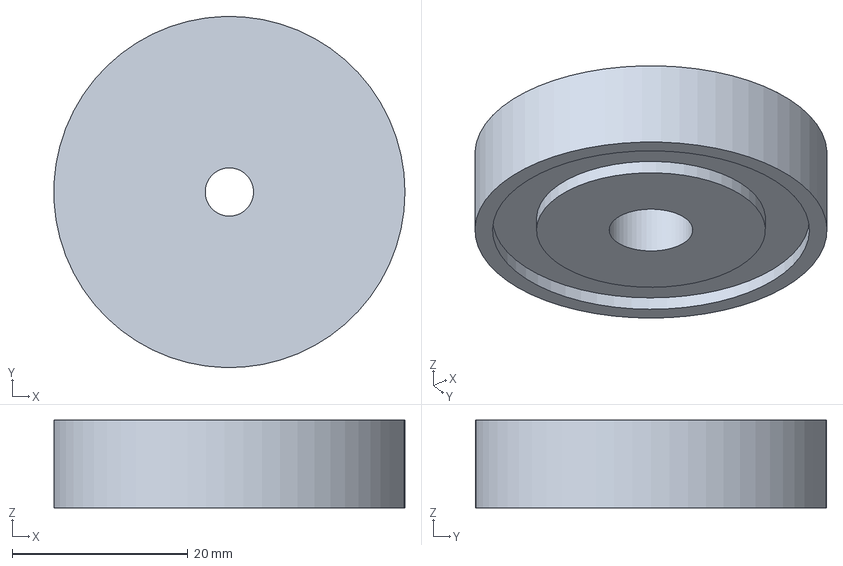
[picture p16: CAD file, 2026-10-16]
hardware/v1/step/fot.step
40.0 x 40.0 x 10.0 mm
