erikhafnor/surdeigsbaker/hardware/v1/dxf/panel_front_taarn.dxf

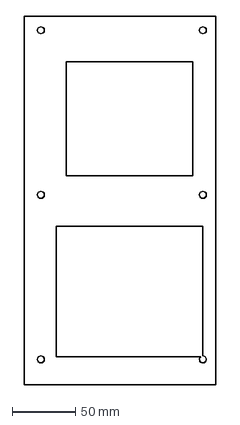
[picture p17: CAD file, 2026-10-16]
hardware/v1/dxf/panel_front_taarn.dxf
151.0 x 291.0 mm
