erikhafnor/surdeigsbaker/hardware/v1/step/dorhengsel_dor.step

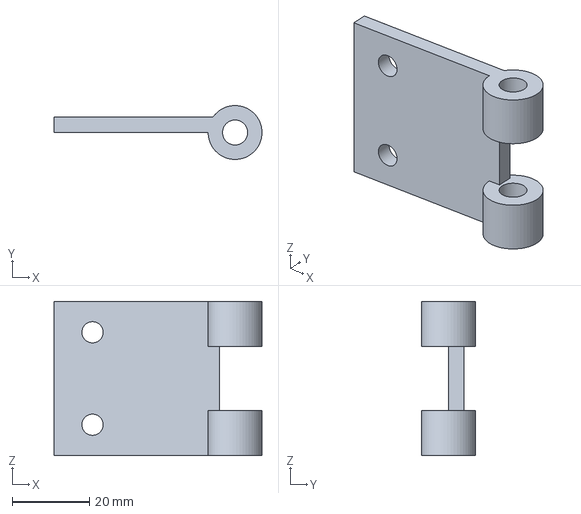
[picture p18: CAD file, 2026-10-16]
hardware/v1/step/dorhengsel_dor.step
54.0 x 14.0 x 40.0 mm
