erikhafnor/surdeigsbaker/hardware/v1/dxf/panel_bak.dxf

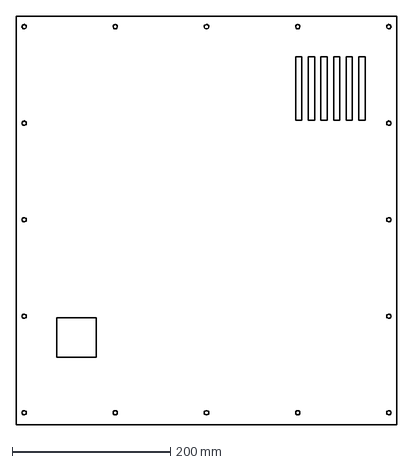
[picture p19: CAD file, 2026-10-16]
hardware/v1/dxf/panel_bak.dxf
481.0 x 516.0 mm
