erikhafnor/surdeigsbaker/hardware/v1/step/fallror_mel.step

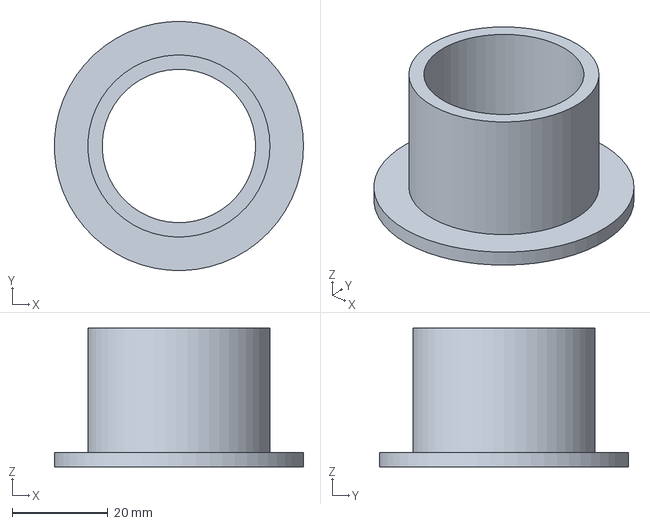
[picture p20: CAD file, 2026-10-16]
hardware/v1/step/fallror_mel.step
52.0 x 52.0 x 29.0 mm
