erikhafnor/surdeigsbaker/hardware/v1/dxf/panel_hoyre.dxf

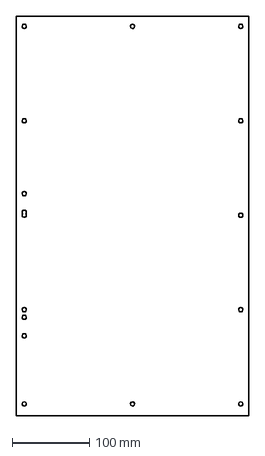
[picture p21: CAD file, 2026-10-16]
hardware/v1/dxf/panel_hoyre.dxf
300.0 x 516.0 mm
