erikhafnor/surdeigsbaker/hardware/v1/step/bryternese.step

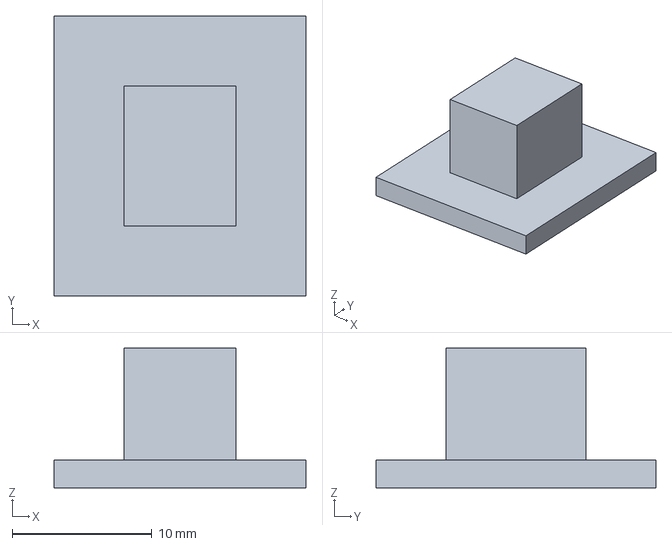
[picture p22: CAD file, 2026-10-16]
hardware/v1/step/bryternese.step
18.0 x 20.0 x 10.0 mm
