erikhafnor/surdeigsbaker/hardware/v1/dxf/panel_front_sokkel.dxf

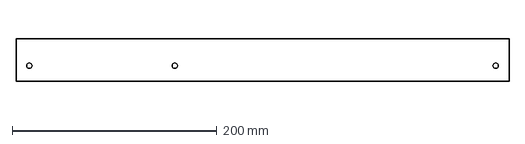
[picture p23: CAD file, 2026-10-16]
hardware/v1/dxf/panel_front_sokkel.dxf
481.0 x 41.0 mm
