erikhafnor/surdeigsbaker/hardware/v1/step/bakpanelinnsats.step

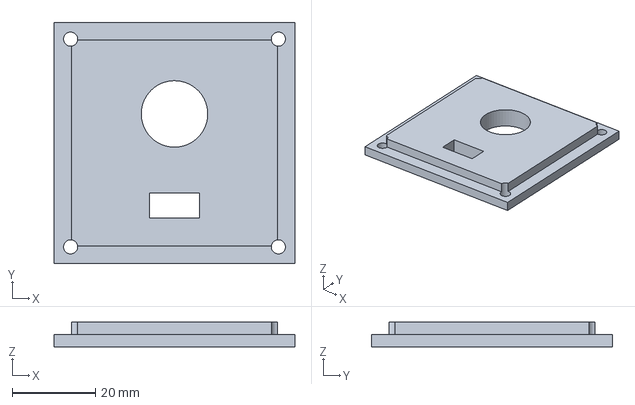
[picture p24: CAD file, 2026-10-16]
hardware/v1/step/bakpanelinnsats.step
58.0 x 58.0 x 6.00 mm
