erikhafnor/surdeigsbaker/hardware/v1/dxf/panel_topp.dxf

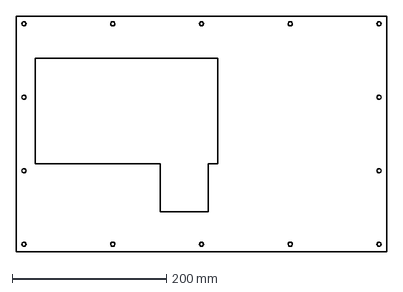
[picture p25: CAD file, 2026-10-16]
hardware/v1/dxf/panel_topp.dxf
481.0 x 306.0 mm
