erikhafnor/surdeigsbaker/hardware/v1/step/saltskrue.step

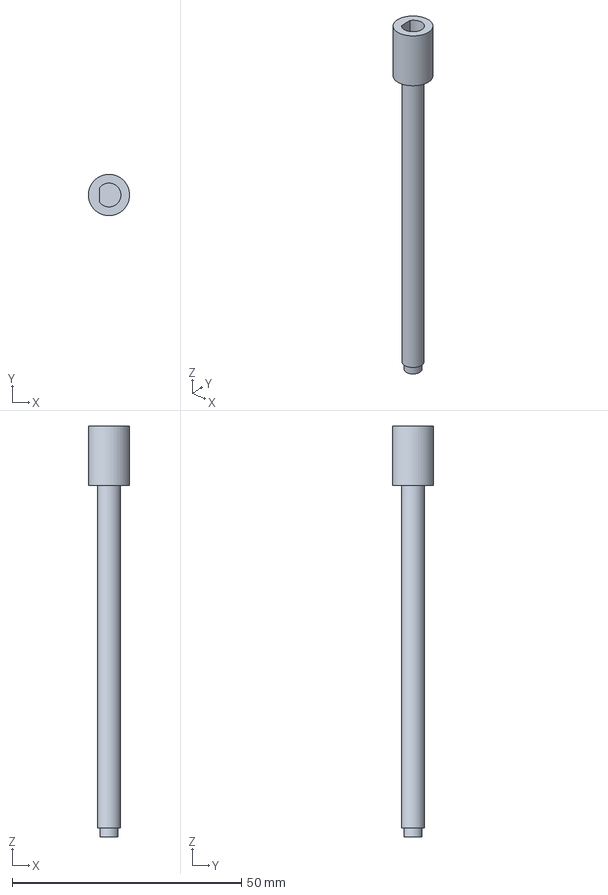
[picture p26: CAD file, 2026-10-16]
hardware/v1/step/saltskrue.step
8.99 x 9.00 x 89.6 mm
