erikhafnor/surdeigsbaker/hardware/v1/dxf/takforing.dxf

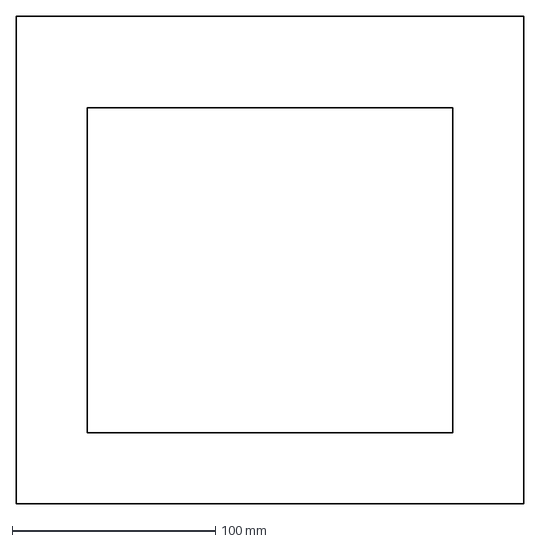
[picture p27: CAD file, 2026-10-16]
hardware/v1/dxf/takforing.dxf
250.0 x 240.0 mm
