erikhafnor/surdeigsbaker/hardware/v1/step/traktlokk.step

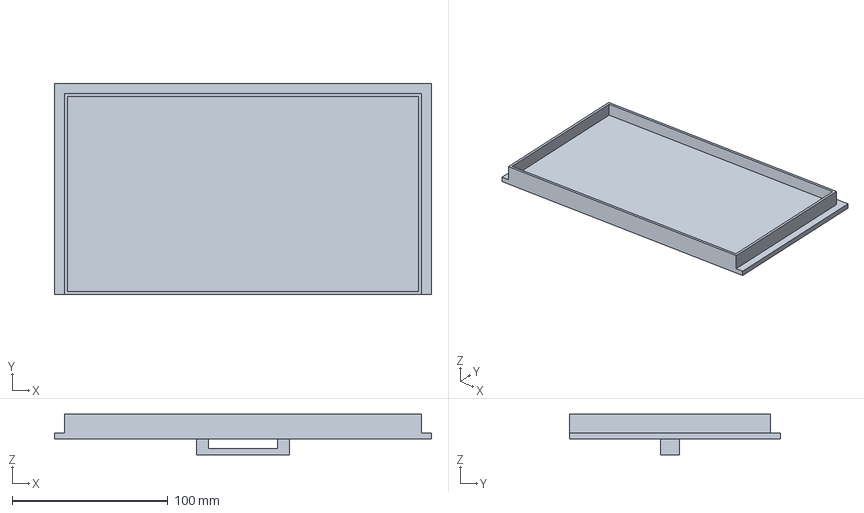
[picture p28: CAD file, 2026-10-16]
hardware/v1/step/traktlokk.step
242.0 x 135.5 x 26.0 mm
