erikhafnor/surdeigsbaker/hardware/v1/dxf/toppplate.dxf

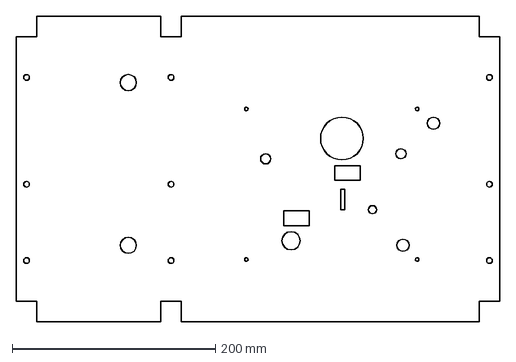
[picture p29: CAD file, 2026-10-16]
hardware/v1/dxf/toppplate.dxf
475.0 x 300.0 mm
