erikhafnor/surdeigsbaker/hardware/v1/step/kontrollpanel.step

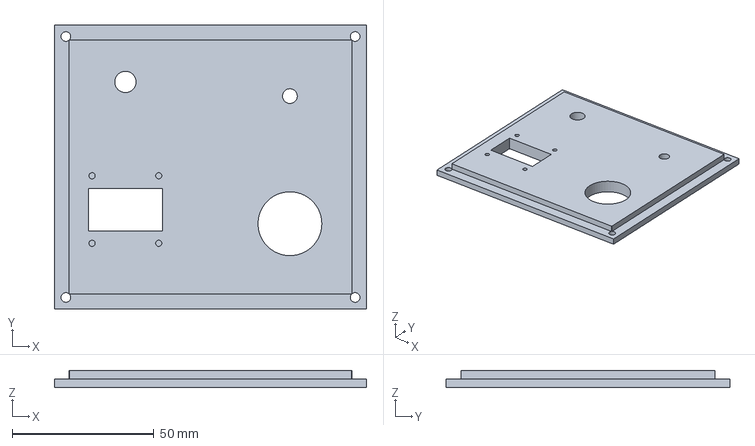
[picture p30: CAD file, 2026-10-16]
hardware/v1/step/kontrollpanel.step
110.0 x 100.0 x 6.00 mm
