erikhafnor/surdeigsbaker/hardware/v1/dxf/panel_bunn.dxf

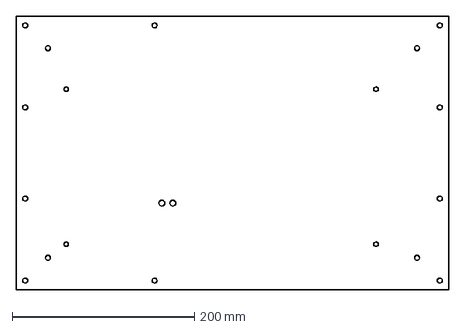
[picture p31: CAD file, 2026-10-16]
hardware/v1/dxf/panel_bunn.dxf
475.0 x 300.0 mm
