erikhafnor/surdeigsbaker/hardware/v1/step/fallror_salt.step

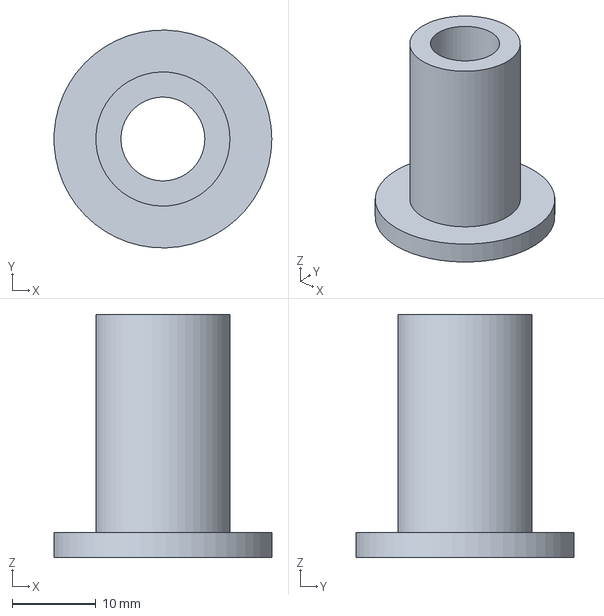
[picture p32: CAD file, 2026-10-16]
hardware/v1/step/fallror_salt.step
26.0 x 26.0 x 29.0 mm
