erikhafnor/surdeigsbaker/hardware/v1/dxf/plattform.dxf

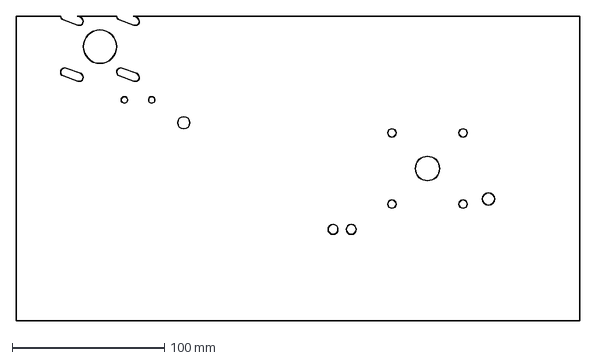
[picture p33: CAD file, 2026-10-16]
hardware/v1/dxf/plattform.dxf
370.0 x 200.0 mm
