erikhafnor/surdeigsbaker/hardware/v1/step/varmekanal.step

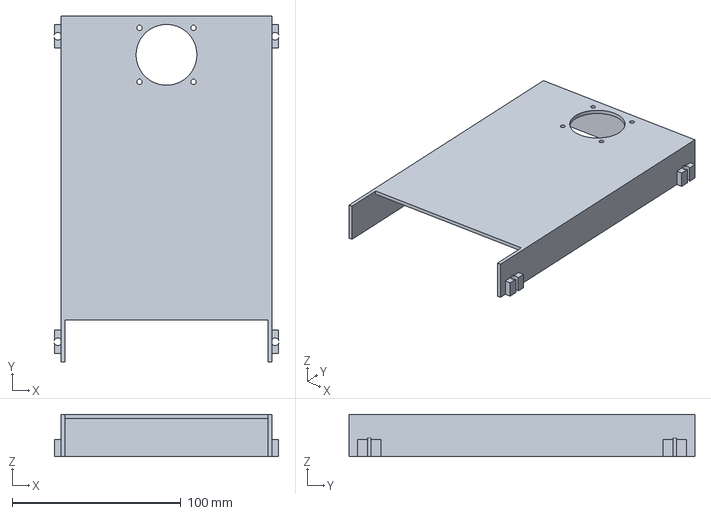
[picture p34: CAD file, 2026-10-16]
hardware/v1/step/varmekanal.step
132.8 x 205.0 x 24.9 mm
