erikhafnor/surdeigsbaker/hardware/v1/step/krage.step

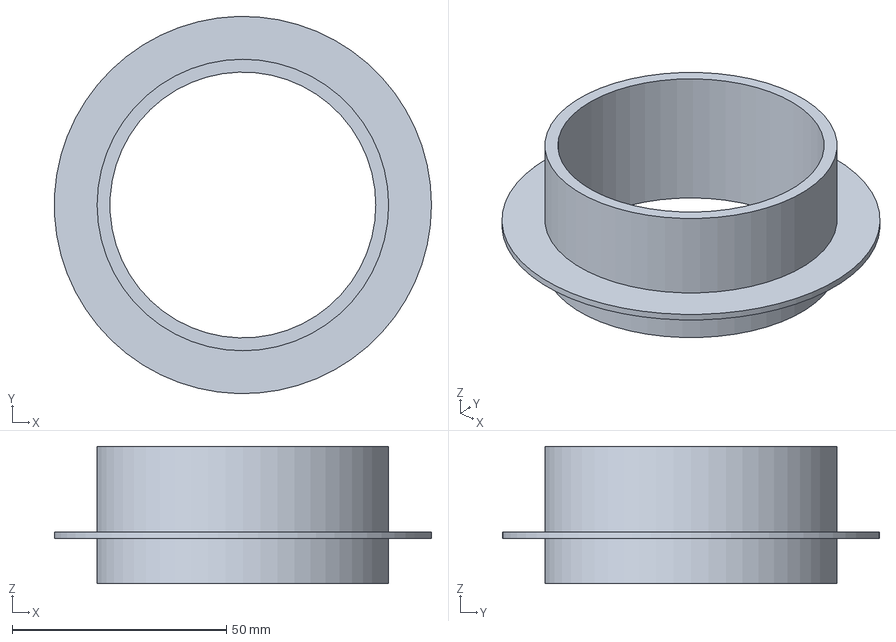
[picture p35: CAD file, 2026-10-16]
hardware/v1/step/krage.step
87.9 x 88.0 x 32.0 mm
