erikhafnor/surdeigsbaker/hardware/v1/step/saltboks.step

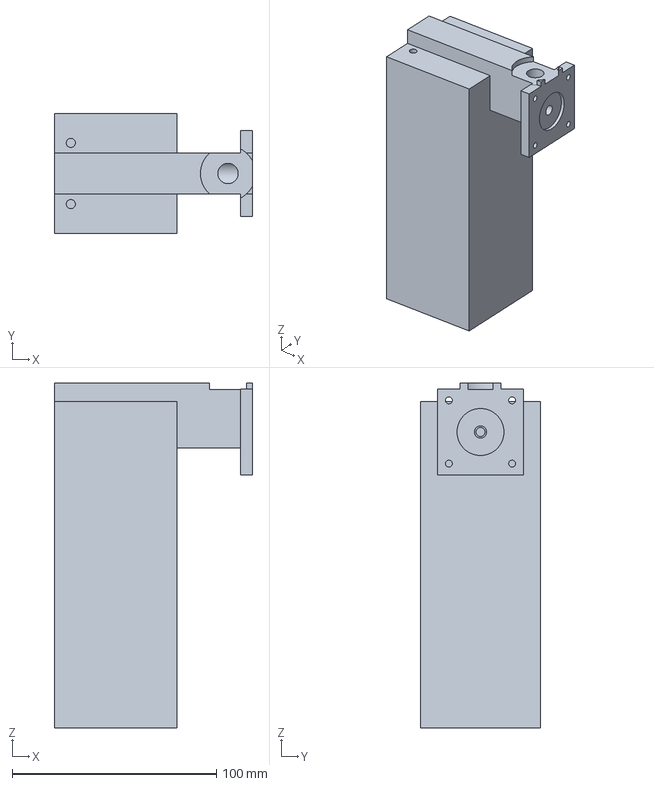
[picture p36: CAD file, 2026-10-16]
hardware/v1/step/saltboks.step
97.0 x 59.0 x 169.0 mm
