erikhafnor/surdeigsbaker/hardware/v1/step/skruror.step

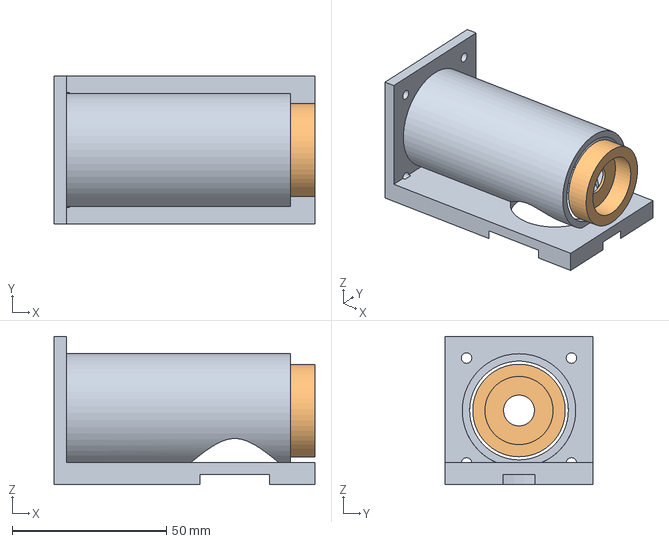
[picture p37: CAD file, 2026-10-16]
hardware/v1/step/skruror.step
84.6 x 48.0 x 48.0 mm
