erikhafnor/surdeigsbaker/hardware/v1/step/formholder.step

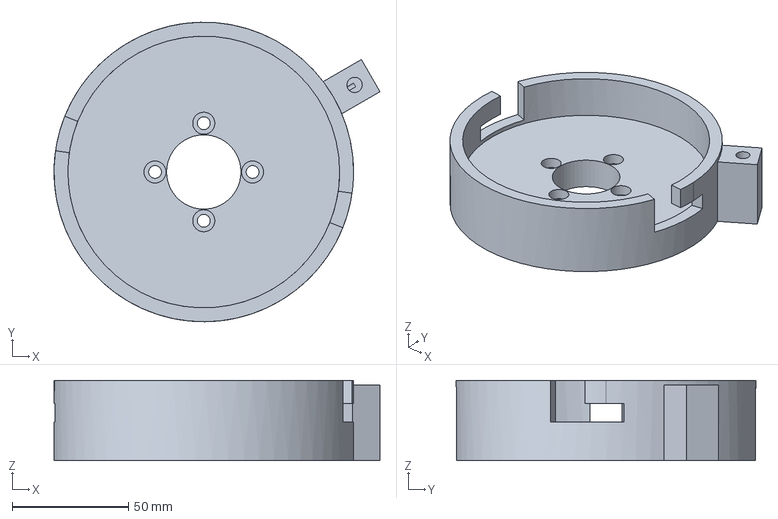
[picture p38: CAD file, 2026-10-16]
hardware/v1/step/formholder.step
140.4 x 129.0 x 34.5 mm
