erikhafnor/surdeigsbaker/hardware/v1/step/lagersoyle.step

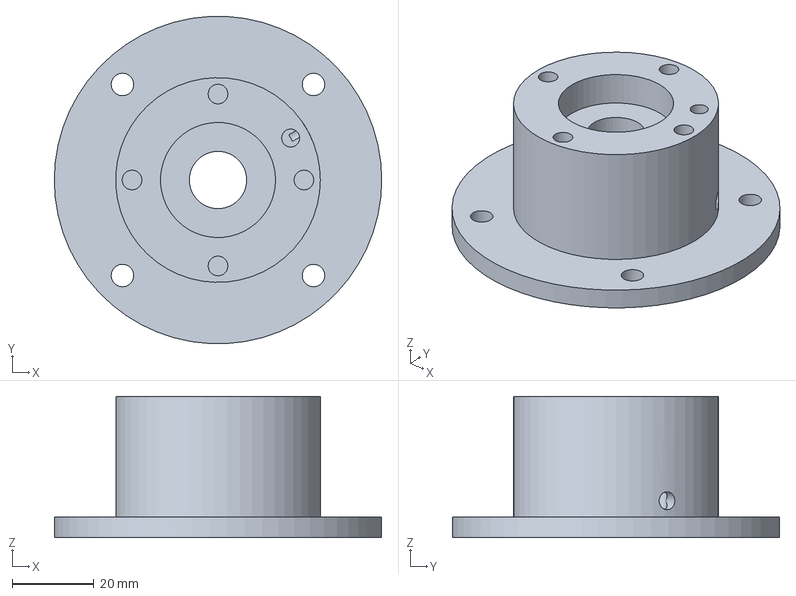
[picture p39: CAD file, 2026-10-16]
hardware/v1/step/lagersoyle.step
80.0 x 79.9 x 34.5 mm
