erikhafnor/surdeigsbaker/hardware/v1/step/melmotorfeste.step

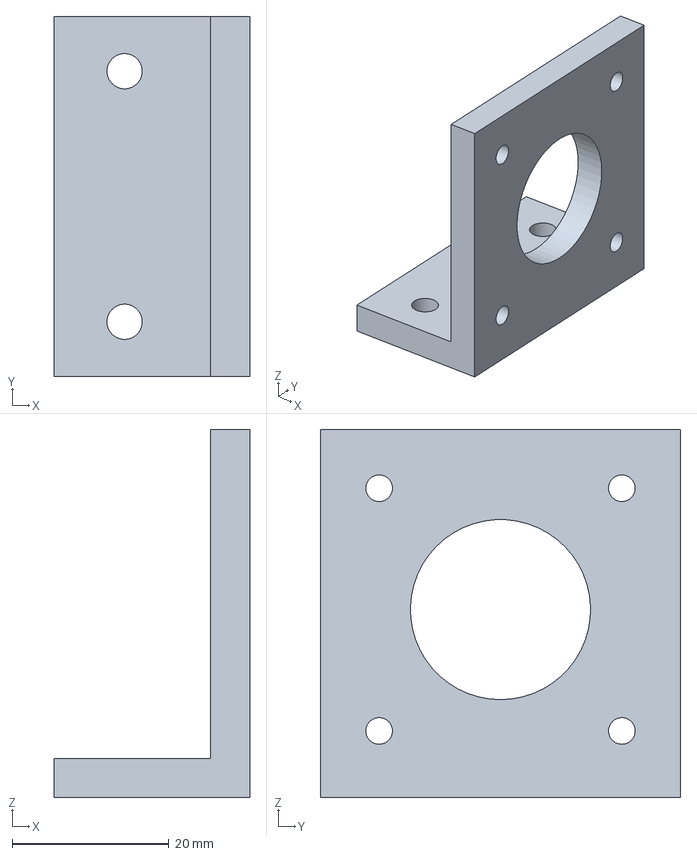
[picture p40: CAD file, 2026-10-16]
hardware/v1/step/melmotorfeste.step
25.0 x 46.0 x 47.0 mm
