erikhafnor/surdeigsbaker/hardware/v1/step/elektronikkplate.step

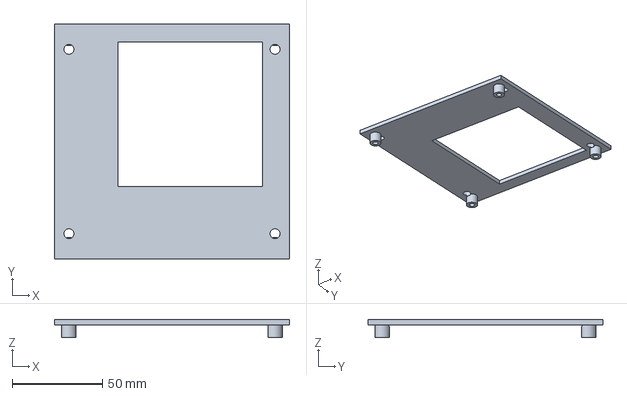
[picture p41: CAD file, 2026-10-16]
hardware/v1/step/elektronikkplate.step
130.0 x 130.0 x 10.0 mm
