erikhafnor/surdeigsbaker/hardware/v1/step/bryterholder.step

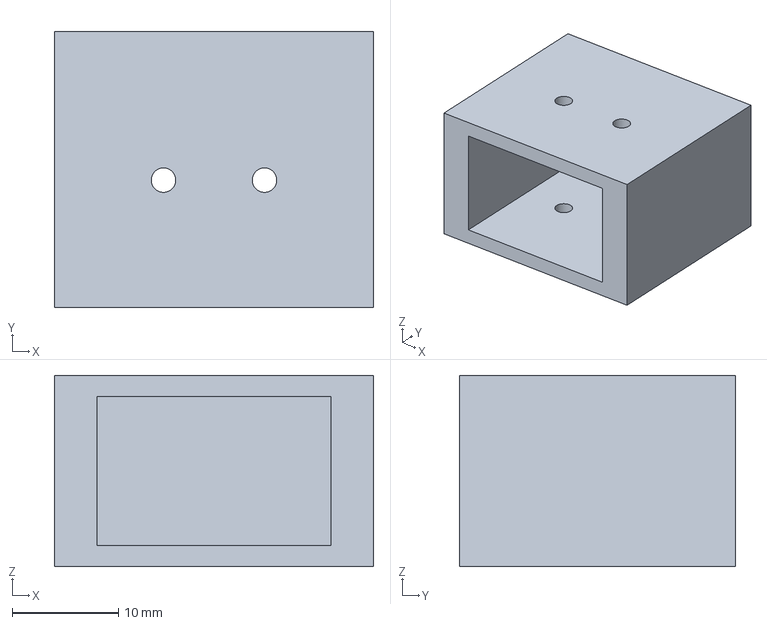
[picture p42: CAD file, 2026-10-16]
hardware/v1/step/bryterholder.step
30.0 x 26.0 x 18.0 mm
