erikhafnor/surdeigsbaker/hardware/v1/step/klaff_salt.step

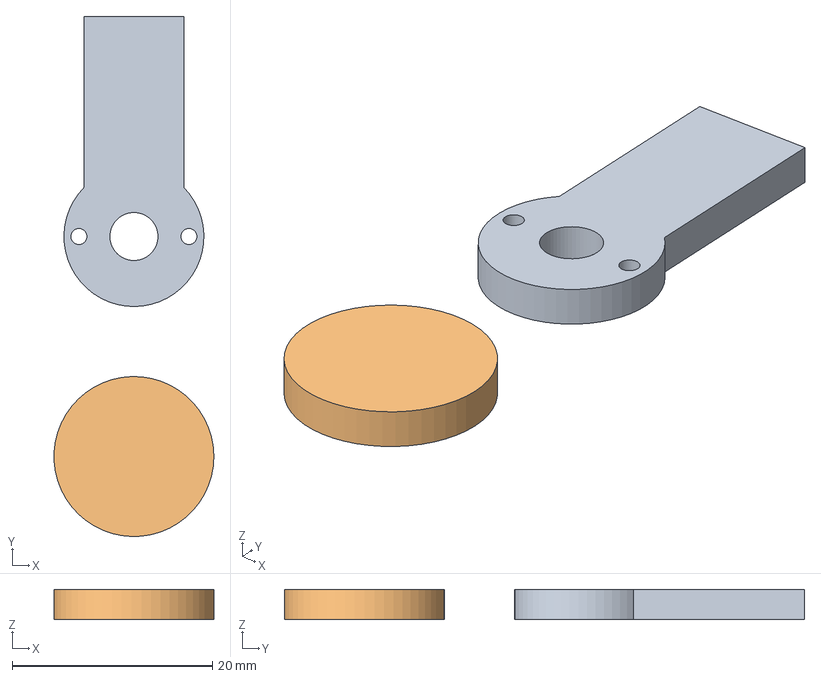
[picture p43: CAD file, 2026-10-16]
hardware/v1/step/klaff_salt.step
16.0 x 52.0 x 3.00 mm
