erikhafnor/surdeigsbaker/hardware/v1/step/trakt.step

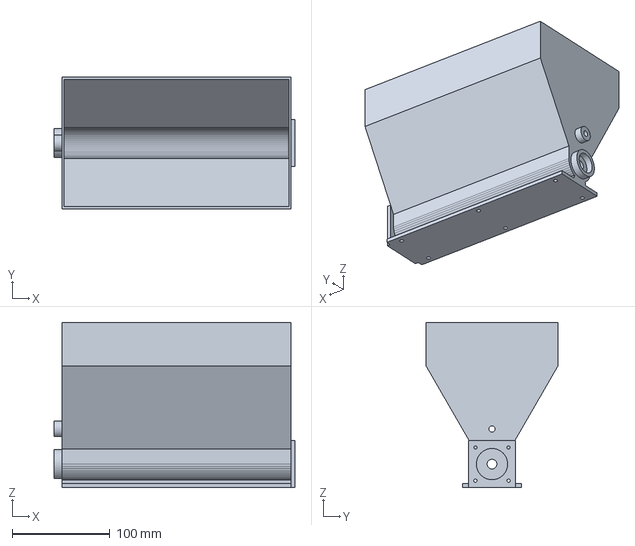
[picture p44: CAD file, 2026-10-16]
hardware/v1/step/trakt.step
246.8 x 134.8 x 169.0 mm
