erikhafnor/surdeigsbaker/hardware/v1/step/dorhengsel_ramme.step

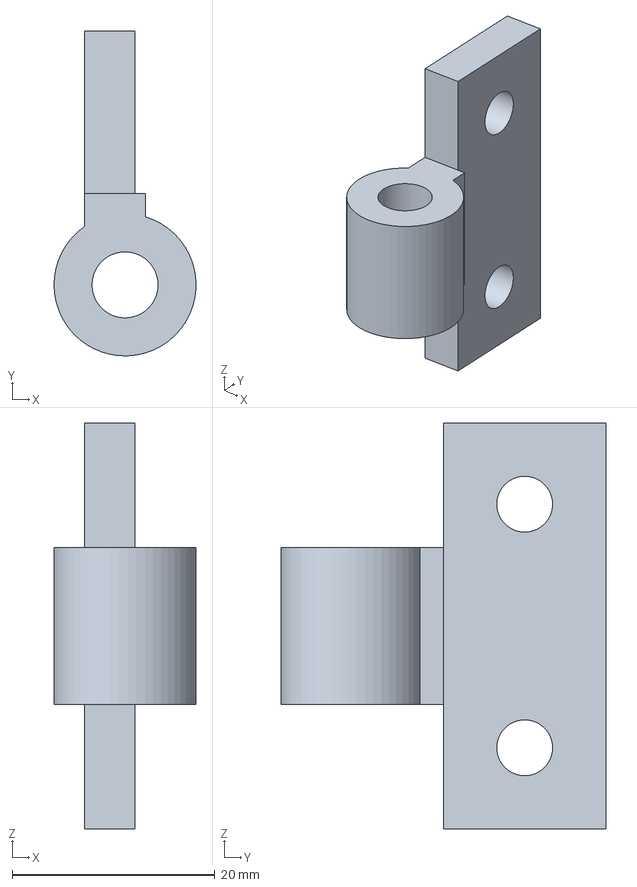
[picture p45: CAD file, 2026-10-16]
hardware/v1/step/dorhengsel_ramme.step
14.0 x 32.0 x 40.0 mm
