erikhafnor/surdeigsbaker/hardware/v1/step/melskrue.step

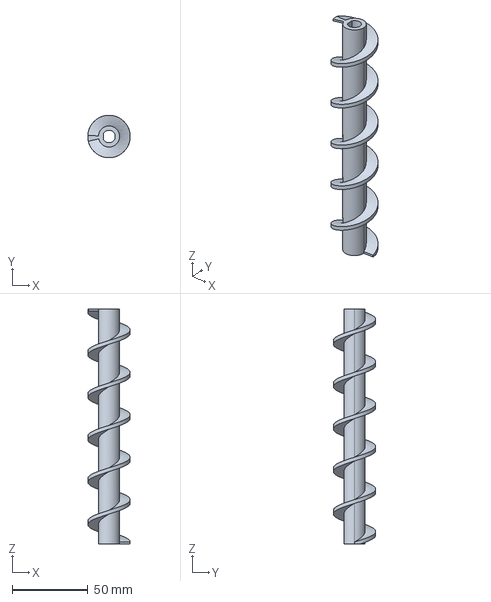
[picture p46: CAD file, 2026-10-16]
hardware/v1/step/melskrue.step
28.0 x 28.0 x 155.0 mm
