erikhafnor/surdeigsbaker/hardware/v1/step/montasje.step

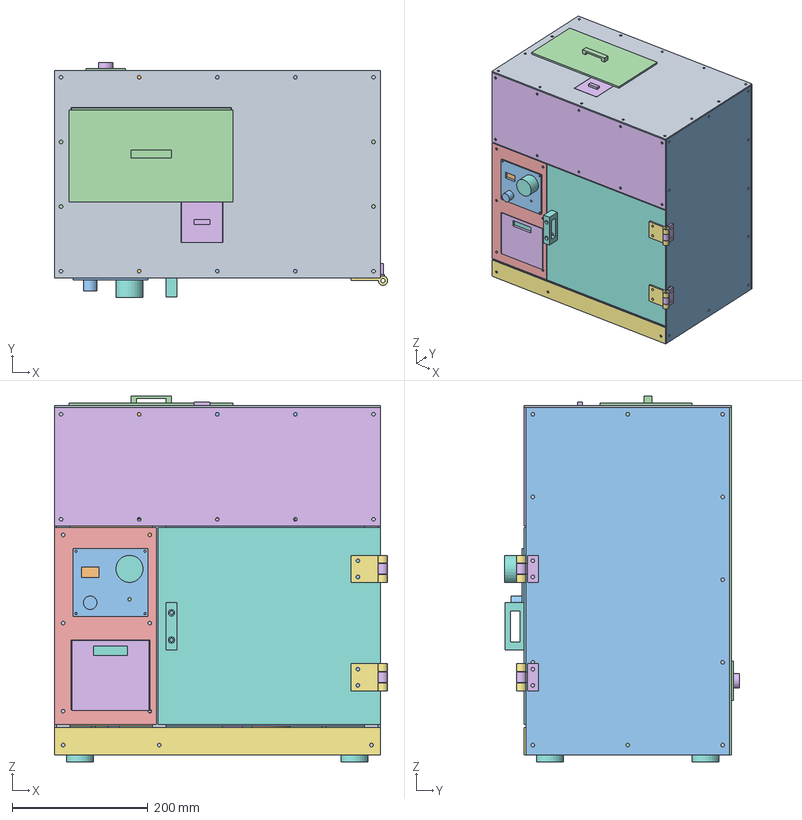
[picture p47: CAD file, 2026-10-16]
hardware/v1/step/montasje.step
492.0 x 347.0 x 540.0 mm
stolpe x 6
tverr_x_taarn x 8
tverr_x_kammer x 8
tverr_y x 9
panel_bunn
mellomgulv
toppplate
plattform
takforing
panel_venstre
panel_hoyre
panel_bak
panel_front_taarn
panel_front_topp
panel_front_sokkel
panel_dor
panel_topp
xps_gulv
xps_venstre
xps_hoyre
xps_bak
xps_tak
dorplugg
brodform
koblingsdel
aksel
reimskive_aksel
reimskive_motor
reim
eltemotor
lastcelle_kloss_topp
lastcelle_kloss_bunn
lastcelle
overlaststopp x 4
melmotor
kobling_mel
saltmotor
melaksel
roreaksel
rorepinner
servo_mel
servo_salt
vanntank
vannpumpe
dyserÃ¸r
varmematte
kjoleribbe
vifte
bÃ¦rekort
e_stopp
oled
dreieknapp
pi_zero
din_kontakt
dorbryter
formholder
lagersoyle
kabelklemme
krage
trakt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
