erikhafnor/surdeigsbaker/hardware/v1/step/kabelklemme.step

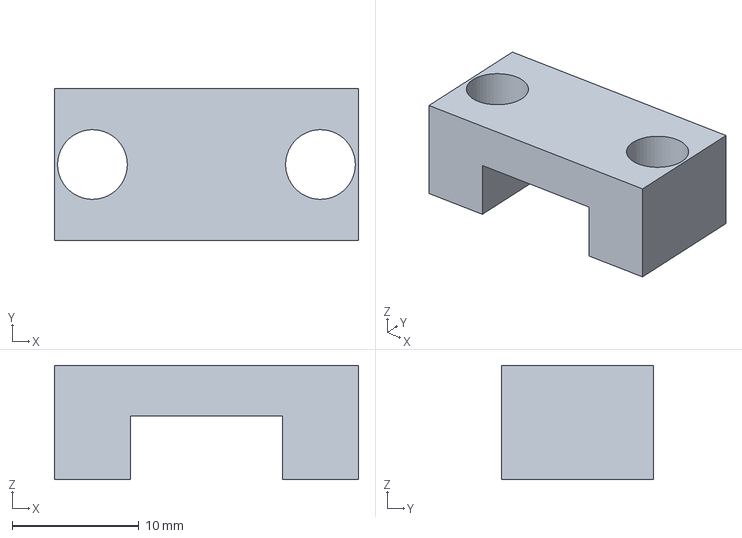
[picture p48: CAD file, 2026-10-16]
hardware/v1/step/kabelklemme.step
24.0 x 12.0 x 9.00 mm
