erikhafnor/surdeigsbaker/hardware/v1/step/tannhjul_rorer.step

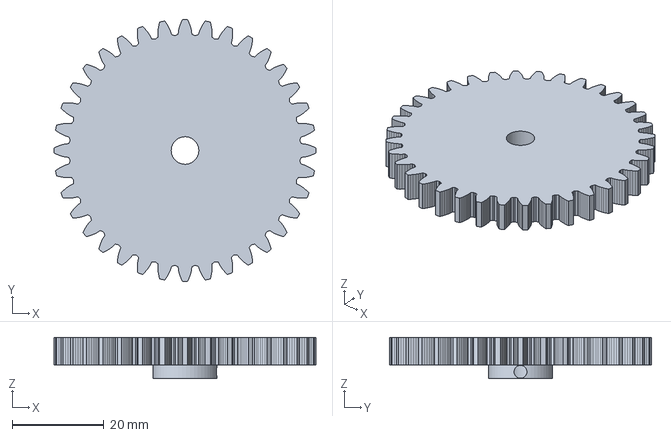
[picture p49: CAD file, 2026-10-16]
hardware/v1/step/tannhjul_rorer.step
57.0 x 57.0 x 9.00 mm
