erikhafnor/surdeigsbaker/hardware/v1/step/saltlokk.step

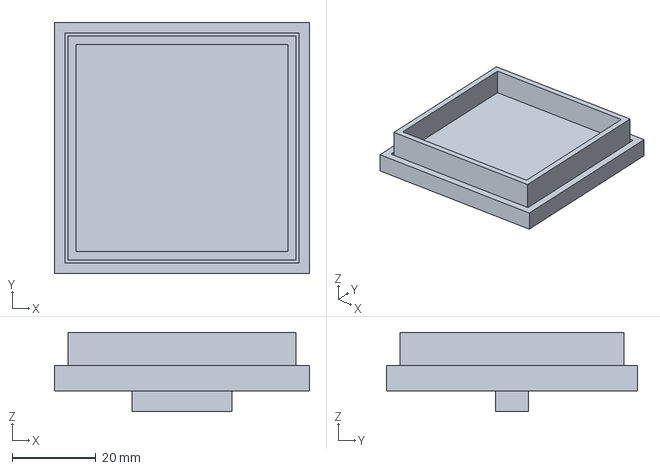
[picture p50: CAD file, 2026-10-16]
hardware/v1/step/saltlokk.step
61.0 x 60.0 x 19.0 mm
