erikhafnor/surdeigsbaker/hardware/v1/step/klaff_mel.step

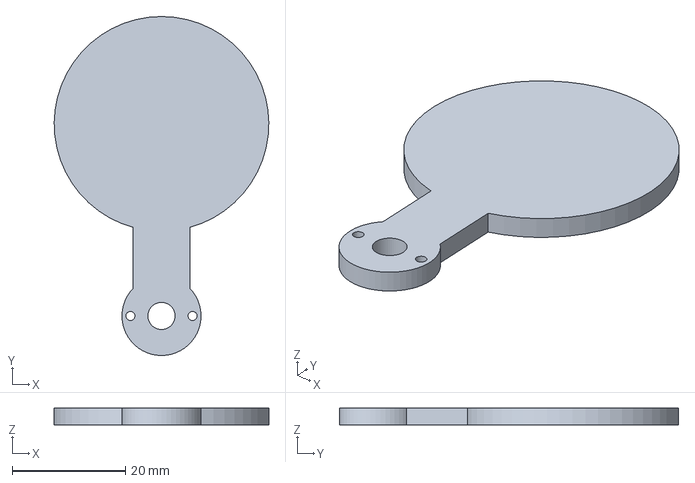
[picture p51: CAD file, 2026-10-16]
hardware/v1/step/klaff_mel.step
38.0 x 60.0 x 3.00 mm
