erikhafnor/surdeigsbaker/hardware/v1/step/takmodul.step

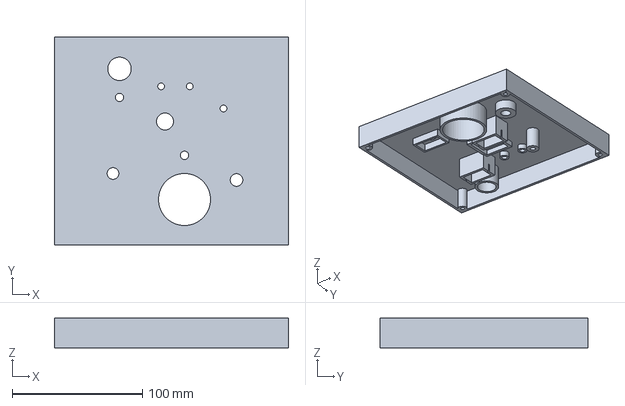
[picture p52: CAD file, 2026-10-16]
hardware/v1/step/takmodul.step
180.0 x 160.0 x 23.0 mm
