erikhafnor/surdeigsbaker/(list of files, cad)

Other CAD files:
hardware/v0/dxf/panel_bak.dxf
hardware/v0/dxf/panel_bunn.dxf
hardware/v0/dxf/panel_front.dxf
hardware/v0/dxf/panel_gulv.dxf
hardware/v0/dxf/panel_lokk_foring.dxf
hardware/v0/dxf/panel_lokk_topp.dxf
hardware/v0/dxf/panel_side_hoyre.dxf
hardware/v0/dxf/panel_side_venstre.dxf
hardware/v0/dxf/varmeplate_aluminium.dxf
hardware/v0/step/bakpanelinnsats.step
hardware/v0/step/bollestotte.step
hardware/v0/step/bollestotte_foler.step
hardware/v0/step/bryterholder.step
hardware/v0/step/bryternese.step
hardware/v0/step/elektronikkplate.step
hardware/v0/step/fot.step
hardware/v0/step/hengsel_lokk.step
hardware/v0/step/hengsel_ramme.step
hardware/v0/step/hjemmeflagg.step
hardware/v0/step/kabelklemme.step
hardware/v0/step/kantpress_hus.step
hardware/v0/step/kantpress_stempel.step
hardware/v0/step/kantpress_tupp.step
hardware/v0/step/kontrollpanel.step
hardware/v0/step/lagerhus.step
hardware/v0/step/montasje.step
hardware/v0/step/motordeksel.step
hardware/v0/step/motorklemme.step
hardware/v0/step/motorplate.step
hardware/v0/step/plateholder_hoyre.step
hardware/v0/step/plateholder_venstre.step
hardware/v0/step/romfolerhus.step
hardware/v0/step/sensorarm.step
hardware/v0/step/sensorhus.step
hardware/v0/step/styrekile.step
hardware/v0/step/varmeplateholder.step
hardware/v0/step/vinkel_2020.step
hardware/v0/stl/bakpanelinnsats.stl
hardware/v0/stl/bollestotte.stl
hardware/v0/stl/bollestotte_foler.stl
hardware/v0/stl/bryterholder.stl
hardware/v0/stl/bryternese.stl
hardware/v0/stl/elektronikkplate.stl
hardware/v0/stl/fot.stl
hardware/v0/stl/hengsel_lokk.stl
hardware/v0/stl/hengsel_ramme.stl
hardware/v0/stl/hjemmeflagg.stl
hardware/v0/stl/kabelklemme.stl
hardware/v0/stl/kantpress_hus.stl
hardware/v0/stl/kantpress_stempel.stl
hardware/v0/stl/kantpress_tupp.stl
hardware/v0/stl/kontrollpanel.stl
hardware/v0/stl/lagerhus.stl
hardware/v0/stl/motordeksel.stl
hardware/v0/stl/motorklemme.stl
hardware/v0/stl/motorplate.stl
hardware/v0/stl/plateholder_hoyre.stl
hardware/v0/stl/plateholder_venstre.stl
hardware/v0/stl/romfolerhus.stl
hardware/v0/stl/sensorarm.stl
hardware/v0/stl/sensorhus.stl
hardware/v0/stl/styrekile.stl
hardware/v0/stl/varmeplateholder.stl
hardware/v0/stl/vinkel_2020.stl
hardware/v1/stl/bakpanelinnsats.stl
hardware/v1/stl/bryterholder.stl
hardware/v1/stl/bryternese.stl
hardware/v1/stl/dorhandtak.stl
hardware/v1/stl/dorhengsel_dor.stl
hardware/v1/stl/dorhengsel_ramme.stl
hardware/v1/stl/elektronikkplate.stl
hardware/v1/stl/fallror_mel.stl
hardware/v1/stl/fallror_salt.stl
hardware/v1/stl/formholder.stl
hardware/v1/stl/fot.stl
hardware/v1/stl/kabelklemme.stl
hardware/v1/stl/klaff_mel.stl
hardware/v1/stl/klaff_salt.stl
hardware/v1/stl/kontrollpanel.stl
hardware/v1/stl/krage.stl
hardware/v1/stl/lagersoyle.stl
hardware/v1/stl/melmotorfeste.stl
hardware/v1/stl/melskrue.stl
hardware/v1/stl/saltboks.stl
hardware/v1/stl/saltlokk.stl
hardware/v1/stl/saltskrue.stl
hardware/v1/stl/skruror.stl
hardware/v1/stl/takmodul.stl
hardware/v1/stl/tankskuff.stl
hardware/v1/stl/tannhjul_rorer.stl
hardware/v1/stl/tannhjul_skrue.stl
hardware/v1/stl/trakt.stl
hardware/v1/stl/traktlokk.stl
hardware/v1/stl/varmekanal.stl
