erikhafnor/surdeigsbaker/hardware/v1/printliste.md

# Printliste – Surdeigsbaker v1

Generert av `hardware/cad/v1/bygg.py`. STL-filene ligger i [`stl/`](stl/) og er allerede snudd til anbefalt printretning.

**Standard:** PETG, 0,2 mm lag, 4 perimetre, 30–40 % gyroid, 5 topp- og bunnlag. Delene som bærer formen og drivverket (formholder, lagersøyle, hengsler og motorfeste) får **6 perimetre** og 50 % fyll.

**Deler som berører mel eller salt** (merket «matkontakt»): naturfarget PETG med samsvarserklæring etter EU 10/2011, printet med dyse av rustfritt stål. Ingen printede deler berører deigen. Brødformen og eltebladet er kjøpt.

| Del | Antall | Materiale | Printretning | Volum (cm³) | Merknad |
|---|---|---|---|---|---|
| [formholder](stl/formholder.stl) | 1 | PETG | som modellert | 201.7 | Bajonett for formfoten. 6 perimetre og 50 % fyll. Mål formen før du printer. |
| [lagersoyle](stl/lagersoyle.stl) | 1 | PETG | som modellert | 68.6 | 2 × 6001-2RS presses inn, ett fra hver side. 4 × M5-innsatser på toppen. 6 perimetre. |
| [kabelklemme](stl/kabelklemme.stl) | 1 | PETG | som modellert | 1.4 | Holder kabelsløyfa fast på plattformen, slik at bare myke ledninger krysser veiespalten. |
| [krage](stl/krage.stl) | 1 | PETG | flensen ned | 23.3 | Limes i hullet i XPS-gulvet. |
| [trakt](stl/trakt.stl) | 1 | PETG (naturfarget, matkontakt) | som modellert | 348.9 | Melbeholder og trau i ett. Rustfri dyse, 0,2 mm lag, 3 perimetre, glatt ytterflate. |
| [skruror](stl/skruror.stl) | 1 | PETG (naturfarget, matkontakt) | som modellert | 41.8 | Lukket rør etter beholderen, utløp og 608-lager for skruen. |
| [fallror_mel](stl/fallror_mel.stl) | 1 | PETG (naturfarget, matkontakt) | flensen ned | 12.5 |  |
| [melskrue](stl/melskrue.stl) | 2 | PETG (naturfarget, matkontakt) | stående | 22.2 | Tres på rustfri D-aksel ⌀8. Begge segmentene er like. |
| [tannhjul_skrue](stl/tannhjul_skrue.stl) | 1 | PETG | liggende | 1.6 | 12 tenner, modul 1.5. M3-settskrue. |
| [tannhjul_rorer](stl/tannhjul_rorer.stl) | 1 | PETG | liggende | 13.8 | 36 tenner. Røreverket går 12/36 så fort som skruen. |
| [melmotorfeste](stl/melmotorfeste.stl) | 1 | PETG | foten ned | 13.0 |  |
| [traktlokk](stl/traktlokk.stl) | 1 | PETG | toppen ned | 208.4 |  |
| [saltboks](stl/saltboks.stl) | 1 | PETG (naturfarget, matkontakt) | toppen ned | 194.9 | Med motorplate for NEMA17 pannekake. Printes opp-ned. |
| [saltlokk](stl/saltlokk.stl) | 1 | PETG | toppen ned | 26.1 | Lomme for silikagel. 2 mm silikonsnor i sporet. |
| [saltskrue](stl/saltskrue.stl) | 1 | PETG (naturfarget, matkontakt) | stående | 2.1 | Stepperens aksel (⌀5 med flate) går rett inn i enden. |
| [fallror_salt](stl/fallror_salt.stl) | 1 | PETG (naturfarget, matkontakt) | flensen ned | 4.5 |  |
| [takmodul](stl/takmodul.stl) | 1 | PETG | toppen ned | 141.6 | ToF, IR-føler, kamera, lys, dyse og de to klaffservoene. Skrus til topplata med M3. |
| [klaff_mel](stl/klaff_mel.stl) | 1 | PETG (naturfarget, matkontakt) | som modellert | 4.1 | Skrus på servoarmen. Dreies 90° til siden under dosering. |
| [klaff_salt](stl/klaff_salt.stl) | 1 | PETG (naturfarget, matkontakt) | som modellert | 1.5 |  |
| [varmekanal](stl/varmekanal.stl) | 1 | PETG | baksiden ned | 81.7 | Holder kjøleribba mot bakveggen. 40 mm vifte foran åpningen øverst. |
| [dorhengsel_ramme](stl/dorhengsel_ramme.stl) | 2 | PETG | liggende | 5.0 | M6 × 45 hengselbolt med låsemutter. |
| [dorhengsel_dor](stl/dorhengsel_dor.stl) | 2 | PETG | liggende | 9.3 |  |
| [dorhandtak](stl/dorhandtak.stl) | 1 | PETG | liggende | 19.7 | Magnet ⌀10 × 3 presses inn bak. Stålskive på skilleveggstolpen. |
| [bryternese](stl/bryternese.stl) | 1 | PETG | flensen ned | 1.4 | Limes på innsiden av døra. |
| [bryterholder](stl/bryterholder.stl) | 1 | PETG | liggende | 7.8 | For KW11-dørbryteren. |
| [kontrollpanel](stl/kontrollpanel.stl) | 1 | PETG | frontflaten ned | 54.5 |  |
| [bakpanelinnsats](stl/bakpanelinnsats.stl) | 1 | PETG | utsiden ned | 15.7 |  |
| [tankskuff](stl/tankskuff.stl) | 1 | PETG | frontflaten ned | 120.1 | Fronten lukker luka for vanntanken. |
| [elektronikkplate](stl/elektronikkplate.stl) | 1 | PETG | veggen ned | 32.3 |  |
| [fot](stl/fot.stl) | 4 | PETG + gummipute | som modellert | 11.3 |  |
