erikhafnor/surdeigsbaker/(commit log)

2026-10-13 Add Surdeigsbaker project plan (DIY sourdough bread machine)
    Staging area for a standalone open-source project. Contains the
    research plan, process analysis of the reference recipe, concept
    options with Pugh matrix, phased roadmap with gates and risk register,
    experiment plan E01-E15, safety/food-contact/regulatory notes,
    draft system architecture, source list, budget, ADRs, templates and
    a draft machine-readable recipe format.
    Claude-Session: https://claude.ai/code/session_01UNifVC7sBRaAaZFtsWXjrQ
2026-10-13 Add 3D CAD tool survey for agent workflows (verified 2026-10-13)
    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
2026-10-13 Add agent-driven design toolchain, guardrails and firmware/lab survey
    - docs/10-verktoykjede.md: recommended open-source toolchain (build123d,
    FreeCAD, KiCad 10 + KiBot, ESPHome + Wokwi, ngspice, Blender) with
    version pins, MCP vetting criteria, pitfalls and a monthly re-scan
    - Firmware/simulation/lab tool survey (verified 2026-10-13)
    - .claude/settings.json: always ask before flashing, printer MCP tools
    and edits to safety-watchdog firmware; deny reading secrets.yaml
    - ADR-005 and links from README, roadmap and folder docs
    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
2026-10-13 Rescope: machine delivers ready-to-bake dough, baking in a regular oven
    The machine now ends at the oven door (ADR-006): levain, mixing,
    kneading, bulk with folds, cold retard and cold hold, with timed
    notifications ("preheat the oven now"). Baking stays manual in a
    regular oven with a Dutch oven.
    - Vision/success criteria: new levels N1-N5, two hand-over variants
    (tip-and-bake / with manual shaping), quality target 80 %, timing
    and cold-hold criteria, power <= 600 W
    - Concepts rewritten: K1 bread-machine drive in a converted wine
    cooler, K2 stainless kneading bowl in proofing chamber (v1 target),
    K3 smart proofing cabinet (first milestone), K4 proof in pot
    - Roadmap, risks, experim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
2026-10-16 Legg til første maskindesign (v0) og fjern kjøling fra planen
    Maskinen slutter nå når deigen er klar for forming (ADR-007). Kald
    etterheving skjer i brukerens kjøleskap, og stekingen i vanlig ovn.
    v0 (ADR-008) er en benkemaskin på 346 × 346 × 541 mm:
    - ramme av 2020-profil med ACM-plater og XPS-isolasjon
    - avtakbar rustfri bolle på en varmeplate med 50 W silikonelement
    - C-krok av rustfri stang, drevet av en 24 V planetgirmotor i et
    vippelokk, med hjemmesensor for parkering før lokket åpnes
    - bare 24 V fra en CE-merket strømforsyning. Lokkbryter og nødstopp
    bryter reléene i maskinvaren. KSD301 og termosikring på varmeplaten.
    - ESP32-S3 med ESPHome
    Innhold:
    - hardware/spe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
    [bakpanelinnsats.step, bakpanelinnsats.stl, bollestotte.step, bollestotte.stl, bollestotte_foler.step, bollestotte_foler.stl, bryterholder.step, bryterholder.stl]
2026-10-16 Undersøk kamera og AI i maskinen, og foreslå ADR-009
    - Nytt forskningsnotat docs/forskning/kamera-og-ai.md: maskinvare
    (ESP32-S3, ESP32-P4, Raspberry Pi med Camera Module 3 Wide, AI HAT+ 2,
    MaixCAM2, Jetson), ESPHome og Home Assistant (AI Task, LLM Vision),
    lokale bildemodeller, hva andre har gjort, metoder for en kjegleformet
    bolle sett ovenfra, og dugg, mel, lys og matsikkerhet.
    - ADR-009 (foreslått): kamera som tillegg i v0 (Pi Zero 2 W + Camera
    Module 3 Wide) og «tynn kant» i v1. Bildene analyseres utenfor
    maskinen, og maskinen virker uten kamera.
    - E14 bruker nå både ToF og kamera, og E18 (feil og aktivitet) er ny.
    - Kameraet er lagt inn i v1-scenariet, arkitekturen o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
2026-10-16 Start v1: tidsplanlegger med simulering og forskningsnotater
    - firmware/v1/components/bakeplan: tidsplanlegger og regulator i ren C++.
    Gjæringsmodellen bygger på Gänzle (1998) og bakerdata. Planleggeren
    regner baklengs fra «klar for forming kl. X», velger levain og
    temperatur, lærer surdeigens aktivitet av målt heving og husker den
    fra baking til baking.
    - firmware/v1/test/planner_test.cpp: enhetstester og simulering i lukket
    sløyfe med treg og rask surdeig, temperaturtreghet, bretting og
    målestøy. Alle tester består.
    - docs/forskning: notater om elting (brødmaskinform fra Panasonic XL),
    dosering, varme og elektronikk, og gjæringsmodellen.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
2026-10-16 Vedta v1-arkitekturen i ADR-010 og legg v0 til side
    v0 bygges ikke. ADR-010 velger brødmaskinform fra Panasonic XL med egen
    girmotor, vekt under hele drivverket, melskrue, saltskrue,
    peristaltisk vannpumpe, vifteoppvarming, 24 V/221 W og ESP32-S3 med
    tidsplanleggeren bakeplan.
    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
2026-10-16 Legg til CAD, stykkliste og koblingsskjema for v1
    Parametrisk build123d-modell fra hardware/spec/v1.yaml: tårn med
    melbeholder, skrue og røreverk, saltboks med skrue, vannpumpe og
    elektronikk, kammer med dør, varmekanal og takmodul, og en
    veieplattform med lastcelle som bærer formholder, lagersøyle,
    reimdrift og eltemotor.
    Sjekkrapporten kontrollerer veiespalten (min. 4 mm), uttak av formen
    (dreie, løfte, trekke ut), dørsvingen (skrå dørplugg), melbeholderen
    (ca. 1,5 kg), røreverket, deigen i formen og effekten.
    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
    [bakpanelinnsats.step, bakpanelinnsats.stl, bryterholder.step, bryterholder.stl, bryternese.step, bryternese.stl, dorhandtak.step, dorhandtak.stl]
2026-10-16 Legg til fastvare for v1: dosering etter vekt, arbeidstrinn og ESPHome
    Bakeprogrammet er vanlig C++ med tester på PC:
    - doser: tarering, grovdosering, finpulser, reversering ved bro og
    varsel når beholderen er tom (mel, vann og salt innen 0,4 g)
    - sequence: levain, deig i porsjoner, fermentolyse, salt og vann,
    elting og tre brettinger, pause når døra åpnes
    - bake: binder tidsplanleggeren og trinnene sammen og gjør
    ToF-avstanden om til heving i %
    - sim: modell av maskinen. bake_test kjører hele bakedager.
    ESPHome-komponenten bakeplan er en tynn innpakning med on_*-kall til
    skript i YAML. Konfigurasjonen er delt i logikk, maskinvare og en
    simulering som kjører hele fastvaren på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
    [bake.cpp, bake.h, bake_test.cpp, bakeplan_component.cpp, bakeplan_component.h, doser.cpp, doser.h, doser_test.cpp]
2026-10-17 Legg til byggeveiledning for v1 og rett statustekst og levainforhold
    Byggeveiledningen dekker giver og mål, innkjøp, print, montering,
    idriftsetting med kalibrering av vekta og test av veiespalten, og en
    bakedag med tider fra simuleringen.
    Statusteksten blir ikke lenger tom etter hendelsestrinn, og forholdet
    i levainen vises med to desimaler når det trengs (1:1,25:1,25).
    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
2026-10-17 Oppdater dokumentasjonen til v1 og merk v0 som referanse
    README, visjon, konsepter, veikart, eksperimenter, sikkerhet,
    arkitektur, budsjett, verktøykjede og bruksscenarier beskriver nå
    prototype v1 (ADR-010). Bruksscenariet bruker tidene fra
    simuleringen: med 1 ss kald surdeig er tidligst ca. 17:30, så
    17:00 krever 2 ss eller matet surdeig.
    Avvik fra rammekravene er skrevet inn: 48 × 31 × 53 cm, mel til to
    brød og 221 W strømforsyning. v0-designet og v0-fastvaren er merket
    som referanse som ikke bygges.
    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
